nthankas/FORTIS/sim/README.md

# sim/

Simulation work for FORTIS. Currently all sims are in `isaac/` (NVIDIA Isaac Sim 5.1, runs outside the dev container on the Windows host).

## Layout

```
sim/isaac/xdrive/
  canonical/    Active sim scripts (xdrive_realwheel.py, xdrive_reactor_arm_v3.py)
  tools/        Analysis / measurement / standalone utilities
  lib/          Shared modules (sim_config.py, arm_ik_v3.py)
  assets/       USD files (diiid_reactor.usd, omniwheels.usd)
  docs/         Spec docs, summaries, R0 plan
  results/      Per-script output (results/<script_name>/...)
  CHANGELOG.md  Milestone history
```

Rule: every script writes its output into `results/<script_name>/`. No flat dumps in `xdrive/`.

## Canonical scripts

- `xdrive/canonical/xdrive_realwheel.py` -- chassis + real Kaya omni-wheel meshes (1 hub + 10 rollers per wheel as separate rigid bodies, after the 5-sphere roller-collider fix). 44-DOF articulation, CPU physics @ 360 Hz, TGS + CCD. Loads `assets/omniwheels.usd`. Supports `--reactor` for the DIII-D environment. Octagonal-prism skeleton `13.082" x 8.54" x 6.0"` with `3"` chamfered face diagonals at the four 45-degree corners (where the wheels mount), total footprint `19.022" x 14.5"`, `2.0"` belly default.
- `xdrive/canonical/xdrive_reactor_arm_v3.py` -- **active build target.** 4-DOF parallel-link arm on the realwheel chassis, flat-stowed. Single-config: 30" carbon-fiber arm, always loaded with 3 lb payload. Heterogeneous motors (NEMA 17 + Cricket J1/J3, NEMA 23 + EG23 + adapter J2, Hitec D845WP J4), 1.128"x1.128" CF tubes, OAK-D Pro camera at L4 midpoint.

Any new sim that needs the FORTIS chassis copies its build path from `canonical/xdrive_realwheel.py`.

## Tools

- `tools/arm_mc_sweep_v4.py` -- **canonical arm sim.** Headless 5k Monte Carlo sweep of (J1, J2, J3, J4); chassis 10.144 kg + arm 6.515 kg + wheels 4 kg = 20.66 kg total (~45 lb). Records analytical and physics tipping per pose. Supersedes the Cartesian-grid `arm_continuous_sweep_v*` pipeline (J1 was fixed at 0; v4 sweeps all four joints).
- `tools/arm_mc_filter_v4.py` -- analytical post-filter for the MC sweep (chassis/self/floor + reactor envelope + tipping); does NOT drop unstable poses.
- `tools/arm_mc_plot_v4.py` -- sampling histogram, torque table, per-joint torque bar chart (J1-J4), and poloidal cross-section.
- `tools/sweep_orbit_realwheel.py` -- orbit-mode torque sweep on the canonical realwheel chassis. Used to validate the 5-sphere roller collider against the previous single-sphere baseline; results live under `results/orbit_realwheel_5sphere/`.
- `tools/clearance_sweep.py`, `tools/measure_r0_port.py`, `tools/test_drift.py` -- standalone analytical / measurement utilities (no Isaac Sim needed).

## Hardware spec parity

`canonical/xdrive_realwheel.py` and `lib/sim_config.py` match the current spec (~15" x 9" x 6", ODrive M8325s drivetrain).

Mass budget (40 lb total robot, ~18.144 kg):

| Component | Mass | Source |
|---|---|---|
| Chassis body (arm lumped on top) | 14.144 kg | `canonical/xdrive_realwheel.py` `CHASSIS_MASS` |
| Wheels | 4 x 1.0 kg | `canonical/xdrive_realwheel.py` `WHEEL_MASS` |
| Total | 18.144 kg (= 40 lb) | |

Sweep range for parameter studies: `lib/sim_config.py` `MASS_VALUES_KG = [13.6, 18.1, 22.7]` (30 / 40 / 50 lb), default 18.1 kg. `lib/arm_ik_v3.py` carries its own `CHASSIS_MASS = 20.4` constant for analytical tipping calculations.

Refer to the OnShape model and BOM for ground-truth dimensions, not these scripts.

## Reactor environment

- USD: `xdrive/assets/diiid_reactor.usd` (OnShape import, triangle mesh collision applied manually in the GUI - **do not regenerate**)
- Ground-truth mesh (not in git): `E:/Capstone/assets/halfReactor.stl`
- Key radii (in `xdrive/lib/sim_config.py`): inner floor 45.8-54.8", step at 55.5", outer floor 56.2-70.3", step height 4.5", central column r ~ 38"
- Z heights: outer floor -49.3", inner floor -53.8"

## Why x-drive (not skid-steer)

The robot straddles a 4.5" step between the inner and outer reactor floor. Skid-steer point turns while straddling this step were tested in 60 configurations - only 3 completed (5%), all with dangerous tilt and drift.

## Running

Requires Isaac Sim 5.1 on the Windows host (not in the dev container).

```bash
# Canonical chassis on flat ground
IsaacSim/python.bat sim/isaac/xdrive/canonical/xdrive_realwheel.py --gui

# Canonical chassis inside reactor (straddling the step)
IsaacSim/python.bat sim/isaac/xdrive/canonical/xdrive_realwheel.py --gui --reactor

# Chassis + v3 arm (30" CF + 3 lb loaded -- the active build target)
IsaacSim/python.bat sim/isaac/xdrive/canonical/xdrive_reactor_arm_v3.py --gui
IsaacSim/python.bat sim/isaac/xdrive/canonical/xdrive_reactor_arm_v3.py --gui --reactor
IsaacSim/python.bat sim/isaac/xdrive/canonical/xdrive_reactor_arm_v3.py --gui --step

# v4 Monte Carlo arm sweep + post-filter + plots
IsaacSim/python.bat sim/isaac/xdrive/tools/arm_mc_sweep_v4.py
python sim/isaac/xdrive/tools/arm_mc_filter_v4.py
python sim/isaac/xdrive/tools/arm_mc_plot_v4.py

# Analytical clearance sweep (no Isaac Sim needed)
python sim/isaac/xdrive/tools/clearance_sweep.py
```

## Next sim work

Sim 2: R0 port entry. Plan in `xdrive/docs/R0_ENTRY_PLAN.md`. Not started.
