nthankas/FORTIS/sim/isaac/xdrive/results/arm_continuous_sweep/sweep_report.pdf

# Arm Torque Sweep Report

## FORTIS Tokamak Inspection Robot

3 arm lengths (36", 30", 24") x 2 loading (bare / 3 lb payload)
2574 poses per config | Step environment (deployment scenario)
Physics torques validated against analytical gravity to < 0.5%

FORTIS Arm Torque Sweep Report | Page 2/6

## Filtered Results

Torques for physically realizable poses on the step environment. All values in Nm. Peak = worst case for motor sizing. Avg = relevant for power/thermal.

Config | Valid | J2 Peak | J3 Peak | J4 Peak | J2 Avg | J3 Avg | J4 Avg
24" bare | 1845 / 2574 | 8.50 | 3.08 | 0.25 | 3.54 | 1.88 | 0.16
24" loaded | 1845 / 2574 | 16.56 | 7.09 | 0.93 | 6.59 | 4.11 | 0.59
30" bare | 1890 / 2574 | 10.58 | 3.78 | 0.38 | 4.50 | 2.26 | 0.24
30" loaded | 1867 / 2574 | 19.30 | 8.80 | 1.40 | 8.32 | 4.92 | 0.89
36" bare | 1880 / 2574 | 12.53 | 4.77 | 0.50 | 5.22 | 2.84 | 0.32
36" loaded | 1694 / 2574 | 19.42 | 11.09 | 1.87 | 8.47 | 5.89 | 1.19

## Motor Sizing

Design-against peak torques. 36" loaded is the hardest case.

Config | J2 Peak | J3 Peak | J4 Peak
24" bare | 8.5 Nm | 3.1 Nm | 0.3 Nm
24" loaded | 16.6 Nm | 7.1 Nm | 0.9 Nm
30" bare | 10.6 Nm | 3.8 Nm | 0.4 Nm
30" loaded | 19.3 Nm | 8.8 Nm | 1.4 Nm
36" bare | 12.5 Nm | 4.8 Nm | 0.5 Nm
36" loaded | 19.4 Nm | 11.1 Nm | 1.9 Nm

## Arm Configuration

Parameter | Value
Joint mass (J3, J4) | 629 g each
Gripper | 500 g
Camera | 98 g (Orbbec Gemini 2, on L1)
Link tube | 0.79" x 0.79" pultruded CF square
Loaded payload | 3 lb (1360 g) at end effector

Camera on L1 affects J2. Gripper at the tip dominates J3/J4. The 3 lb payload roughly doubles peak torques.

## Link Deflection Under Load

CF tube: 25492 square (1.250" ID, 1.380" OD, 0.065" wall, E = 80.7 GPa, I = 2.42e-8 m4). Linear density 0.226 lb/ft.

### Tip Load on L1 (Loaded Configs)

Outboard of J2: J3 (629 g) + L2 + J4 (629 g) + L3 + EE (1860 g).

Config | L2 Mass | L3 Mass | Total Load
36" loaded | ~110 g | ~30 g | 3.26 kg (32.0 N)
30" loaded | ~88 g | ~22 g | 3.23 kg (31.7 N)
24" loaded | ~73 g | ~15 g | 3.21 kg (31.5 N)

### L1 Deflection

Config | Force (N) | Length (m) | Deflection (mm)
36" loaded | 32.0 | 0.432 | 0.44
30" loaded | 31.7 | 0.381 | 0.30
24" loaded | 31.5 | 0.254 | 0.09

### L2 Deflection

Outboard of J3: J4 (629 g) + L3 + EE (1860 g).

Config | Force (N) | Length (m) | Deflection (mm)
36" loaded | 24.5 | 0.381 | 0.23
30" loaded | 24.4 | 0.305 | 0.12
24" loaded | 24.3 | 0.305 | 0.12

### Total EE Sag (Loaded, Stacked)

Config | L1 | L2 | L3 | Total
36" loaded | 0.44 mm | 0.23 mm | ~0.02 mm | ~0.7 mm
30" loaded | 0.30 mm | 0.12 mm | ~0.01 mm | ~0.4 mm
24" loaded | 0.09 mm | 0.12 mm | ~0.01 mm | ~0.2 mm

Under 1 mm worst case. CF tube stiffness is not a concern.

## Chassis Stability

Static CG projection of chassis (20.4 kg) + arm onto the ground plane, checked against the wheel support polygon. J1 swept 0-345 deg in 15 deg steps.

Assumes level chassis. The 4.5" step tilt will reduce margins on the downhill side. Step tilt correction is a follow-up.

Config | Rejected | Worst Margin | Avg Margin | Tight (< 10 mm)
24" bare | 0 (0.0%) | 43.0 mm / 1.69" | 74.2 mm | 0
24" loaded | 0 (0.0%) | 11.4 mm / 0.45" | 45.7 mm | 0
30" bare | 0 (0.0%) | 33.8 mm / 1.33" | 63.0 mm | 0
30" loaded | 23 (1.2%) | 0.5 mm / 0.02" | 35.5 mm | 139 (7.4%)
36" bare | 0 (0.0%) | 25.2 mm / 0.99" | 54.7 mm | 0
36" loaded | 186 (9.9%) | 0.0 mm / 0.00" | 28.4 mm | 151 (8.9%)

Rejected poses are fully-extended with J1 ~ 90 deg (arm sideways). 24" is unconditionally stable. 36" loaded rejects ~10% at full extension.

## Filtering Details

A pose is rejected if any check fails:
Chassis collision Link sample points inside chassis bounding box (10 mm margin). Self-collision (L3-L1) L3 and L1 segments closer than 15 mm.
Self-collision (L3-J1) L3 enters J1 base volume.
Floor collision Any joint or link midpoint below floor (10 mm margin).
Tipping CG projection outside wheel polygon at any J1 angle.

### Rejection Breakdown

Arm | Loading | Valid | Chassis | Self L3-L1 | Self L3-J1 | Floor | Tip
24" | bare | 1845 (71.7%) | 487 | 100 | 0 | 142 | 0
24" | loaded | 1845 (71.7%) | 487 | 100 | 0 | 142 | 0
30" | bare | 1890 (73.4%) | 380 | 100 | 0 | 204 | 0
30" | loaded | 1867 (72.5%) | 380 | 100 | 0 | 204 | 23
36" | bare | 1880 (73.0%) | 353 | 74 | 4 | 263 | 0
36" | loaded | 1694 (65.8%) | 353 | 74 | 4 | 263 | 186

## Appendix: Raw and Flat Data

### Raw Torques (Unfiltered, Step)

All 2574 poses including impossible configurations.

Config | J2 Peak | J3 Peak | J4 Peak | J2 Avg | J3 Avg | J4 Avg
24" bare | 8.50 | 3.08 | 0.25 | 3.78 | 1.81 | 0.16
24" loaded | 16.56 | 7.09 | 0.93 | 6.86 | 3.95 | 0.59
30" bare | 10.58 | 3.78 | 0.38 | 4.73 | 2.18 | 0.24
30" loaded | 20.65 | 8.80 | 1.40 | 8.53 | 4.75 | 0.89
36" bare | 12.53 | 4.77 | 0.50 | 5.45 | 2.74 | 0.32
36" loaded | 24.60 | 11.09 | 1.88 | 9.89 | 5.96 | 1.18

### Flat Environment (Filtered)

NOT reliable for motor sizing. Chassis slides on flat ground during arm teleport, inflating measured torques by 100-200%. Use step data for all design decisions.

Config | J2 Peak | J3 Peak | J4 Peak | J2 Avg | J3 Avg | J4 Avg
24" bare | 17.37 | 10.55 | 0.75 | 3.67 | 1.93 | 0.16
24" loaded | 22.80 | 11.63 | 1.67 | 6.71 | 4.15 | 0.59
30" bare | 13.17 | 5.86 | 0.71 | 4.52 | 2.27 | 0.24
30" loaded | 33.73 | 16.95 | 2.74 | 8.53 | 5.00 | 0.89
36" bare | 25.39 | 11.74 | 1.19 | 5.74 | 3.05 | 0.34
36" loaded | 37.08 | 24.25 | 4.21 | 10.01 | 6.32 | 1.20

## Method

Isaac Sim headless, 360 Hz. Collision disabled on arm links so every joint combo is reachable. Each pose: teleport to target angles, PD holds ~0.4 s, measure torques ~0.1 s. Post-filter removes impossible poses (chassis/self/floor collision, tipping).
All 6 step configs: 2574/2574 converged, 0 NaN. Physics torques match analytical gravity to < 0.5%.
