nthankas/FORTIS/sim/isaac/xdrive/results/step_arch_optimizer/step_arch_analysis.png

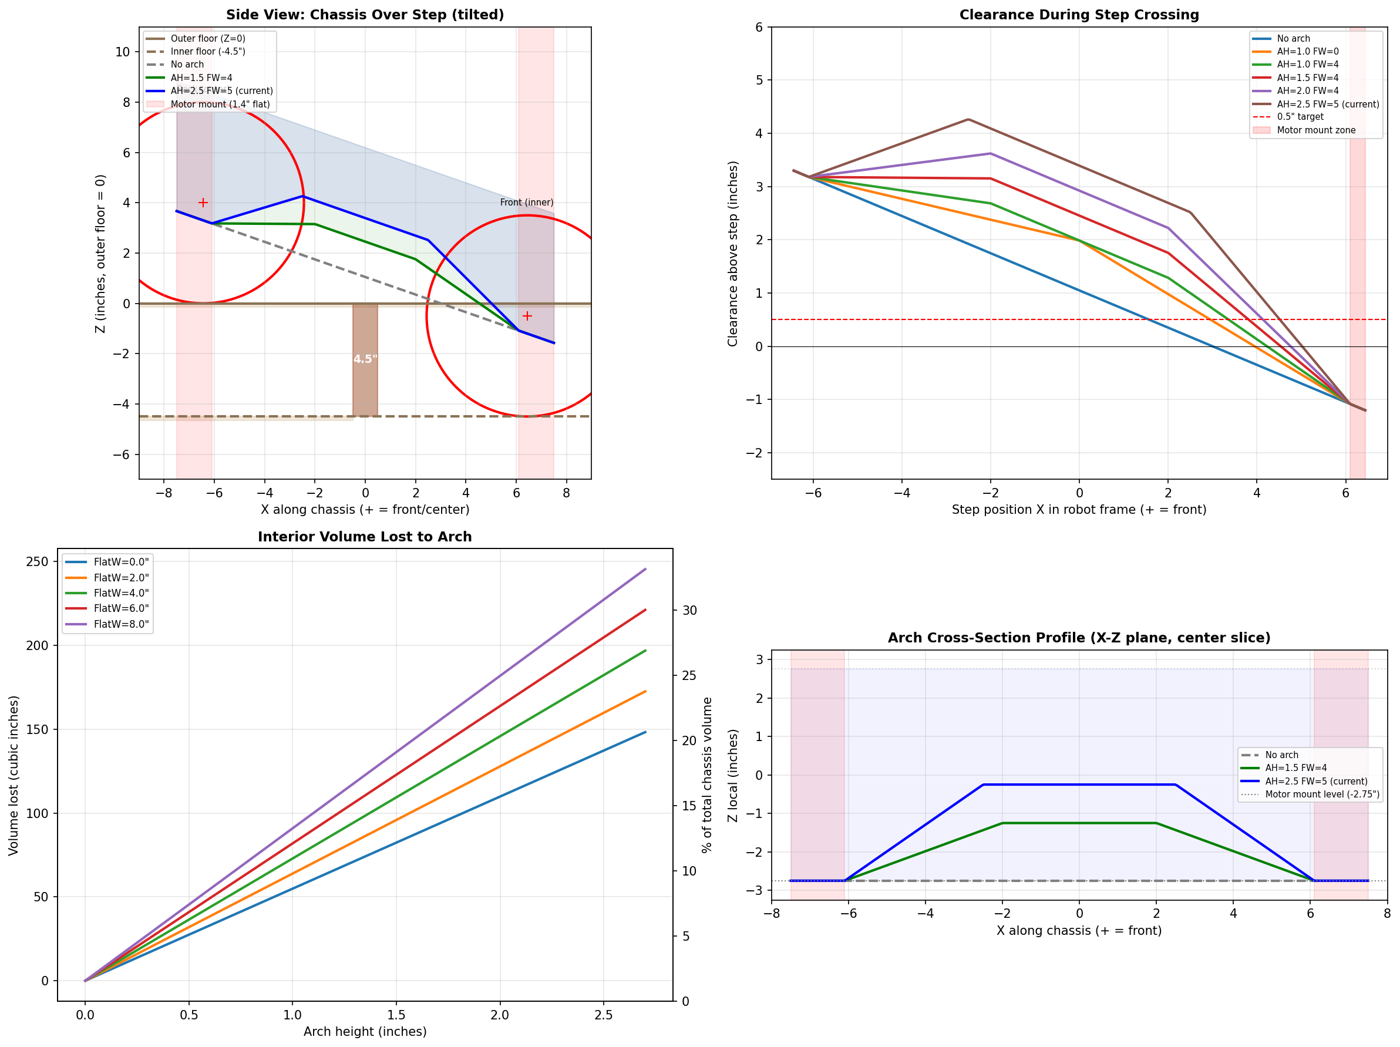
sim/isaac/xdrive/results/step_arch_optimizer/step_arch_analysis.png
