nthankas/FORTIS/sim/isaac/xdrive/results/arm_continuous_sweep/24in_bare_flat_filtered.csv

pose_idx | j2_deg | j3_deg | j4_deg | j2_fk_deg | j3_fk_deg | j4_fk_deg | j1_actual_deg | j2_actual_deg | j3_actual_deg | j4_actual_deg | position_error_deg | tau_j1_Nm | tau_j2_Nm | tau_j3_Nm | tau_j4_Nm | tau_j2_analytical | tau_j3_analytical | tau_j4_analytical | ee_x_m | ee_y_m | ee_z_m | j3_local_x_m | j3_local_z_m | j4_local_x_m | j4_local_z_m | ee_local_x_m | ee_local_z_m | chassis_roll_deg | chassis_pitch_deg | converged | filter_status | filter_chassis | filter_self_L4_L2 | filter_self_L4_J1 | filter_floor | filter_converged | filter_tipping | tip_worst_margin_m | tip_worst_j1_deg | tip_j1_stable_count | tip_cg_x_m | tip_cg_y_m
0 | -30.0 | -170.0 | -150.0 | -30.0 | 10.0 | 30.0 | -0.004 | -29.550 | -169.804 | -149.999 | 0.450 | 0.0992 | -7.6672 | -2.9376 | -0.2459 | -7.6362 | -2.9295 | -0.2466 | 0.384375 | 0.069103 | 0.498678 | 0.263965 | -0.152400 | 0.502646 | -0.239273 | 0.552675 | -0.230452 | -0.217 | -0.042 | True | chassis_collision | True | False | False | False | True | False
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
