nthankas/FORTIS/sim/isaac/xdrive/results/arm_continuous_sweep/24in_bare_flat.csv

pose_idx | j2_deg | j3_deg | j4_deg | j2_fk_deg | j3_fk_deg | j4_fk_deg | j1_actual_deg | j2_actual_deg | j3_actual_deg | j4_actual_deg | position_error_deg | tau_j1_Nm | tau_j2_Nm | tau_j3_Nm | tau_j4_Nm | tau_j2_analytical | tau_j3_analytical | tau_j4_analytical | ee_x_m | ee_y_m | ee_z_m | j3_local_x_m | j3_local_z_m | j4_local_x_m | j4_local_z_m | ee_local_x_m | ee_local_z_m | chassis_roll_deg | chassis_pitch_deg | converged
0 | -30.0 | -170.0 | -150.0 | -30.0 | 10.0 | 30.0 | -0.004 | -29.550 | -169.804 | -149.999 | 0.450 | 0.0992 | -7.6672 | -2.9376 | -0.2459 | -7.6362 | -2.9295 | -0.2466 | 0.384375 | 0.069103 | 0.498678 | 0.263965 | -0.152400 | 0.502646 | -0.239273 | 0.552675 | -0.230452 | -0.217 | -0.042 | True
1 | -30.0 | -170.0 | -120.0 | -30.0 | 10.0 | 60.0 | -0.005 | -29.552 | -169.885 | -119.999 | 0.448 | 0.0395 | -7.6438 | -2.8961 | -0.1888 | -7.5814 | -2.8747 | -0.1918 | 0.377547 | 0.081554 | 0.475519 | 0.263965 | -0.152400 | 0.502646 | -0.239273 | 0.541562 | -0.206620 | -0.150 | -0.032 | True
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
