nthankas/FORTIS/sim/isaac/xdrive/results/arm_continuous_sweep/24in_loaded_flat.csv

pose_idx | j2_deg | j3_deg | j4_deg | j2_fk_deg | j3_fk_deg | j4_fk_deg | j1_actual_deg | j2_actual_deg | j3_actual_deg | j4_actual_deg | position_error_deg | tau_j1_Nm | tau_j2_Nm | tau_j3_Nm | tau_j4_Nm | tau_j2_analytical | tau_j3_analytical | tau_j4_analytical | ee_x_m | ee_y_m | ee_z_m | j3_local_x_m | j3_local_z_m | j4_local_x_m | j4_local_z_m | ee_local_x_m | ee_local_z_m | chassis_roll_deg | chassis_pitch_deg | converged
0 | -30.0 | -170.0 | -150.0 | -30.0 | 10.0 | 30.0 | -0.007 | -29.010 | -169.330 | -149.998 | 0.990 | -5.4290 | -13.9465 | -6.2557 | -0.7999 | -15.0152 | -6.7842 | -0.9145 | 0.365299 | 0.026891 | 0.491494 | 0.263965 | -0.152400 | 0.502646 | -0.239273 | 0.552675 | -0.230452 | -0.009 | -0.007 | True
1 | -30.0 | -170.0 | -120.0 | -30.0 | 10.0 | 60.0 | -0.007 | -28.985 | -169.649 | -119.998 | 1.015 | 0.7987 | -18.2542 | -8.0484 | -0.7870 | -14.8120 | -6.5810 | -0.7114 | 0.354565 | 0.028157 | 0.469578 | 0.263965 | -0.152400 | 0.502646 | -0.239273 | 0.541562 | -0.206620 | -0.021 | -0.024 | True
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
