nthankas/FORTIS/sim/isaac/xdrive/results/arm_continuous_sweep/30in_bare_flat.csv

pose_idx | j2_deg | j3_deg | j4_deg | j2_fk_deg | j3_fk_deg | j4_fk_deg | j1_actual_deg | j2_actual_deg | j3_actual_deg | j4_actual_deg | position_error_deg | tau_j1_Nm | tau_j2_Nm | tau_j3_Nm | tau_j4_Nm | tau_j2_analytical | tau_j3_analytical | tau_j4_analytical | ee_x_m | ee_y_m | ee_z_m | j3_local_x_m | j3_local_z_m | j4_local_x_m | j4_local_z_m | ee_local_x_m | ee_local_z_m | chassis_roll_deg | chassis_pitch_deg | converged
0 | -30.0 | -170.0 | -150.0 | -30.0 | 10.0 | 30.0 | -0.004 | -29.630 | -169.815 | -149.999 | 0.370 | -0.8911 | -10.6520 | -4.1215 | -0.4020 | -9.5115 | -3.6038 | -0.3707 | 0.495104 | 0.096834 | 0.545010 | 0.329956 | -0.190500 | 0.616374 | -0.294748 | 0.691416 | -0.281516 | 0.029 | -0.108 | True
1 | -30.0 | -170.0 | -120.0 | -30.0 | 10.0 | 60.0 | -0.004 | -29.638 | -169.890 | -119.999 | 0.362 | 0.9243 | -9.6909 | -3.6026 | -0.2797 | -9.4292 | -3.5214 | -0.2884 | 0.474418 | 0.098293 | 0.509982 | 0.329956 | -0.190500 | 0.616374 | -0.294748 | 0.674747 | -0.245767 | 0.021 | -0.110 | True
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
