nthankas/FORTIS/sim/isaac/xdrive/results/arm_continuous_sweep/30lb/torque_table_v3_30lb.png

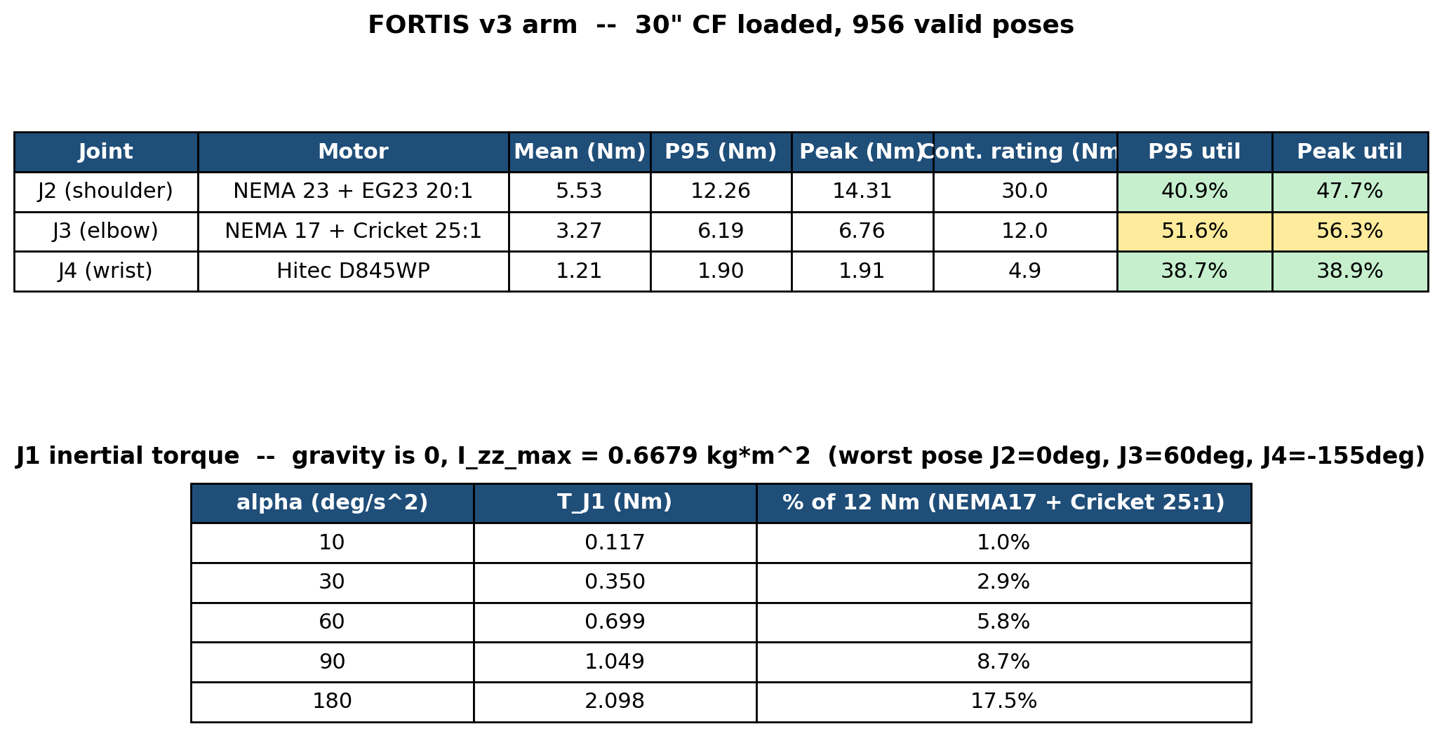
sim/isaac/xdrive/results/arm_continuous_sweep/30lb/torque_table_v3_30lb.png
