nthankas/FORTIS/sim/isaac/xdrive/results/arm_continuous_sweep/stability_v3.png

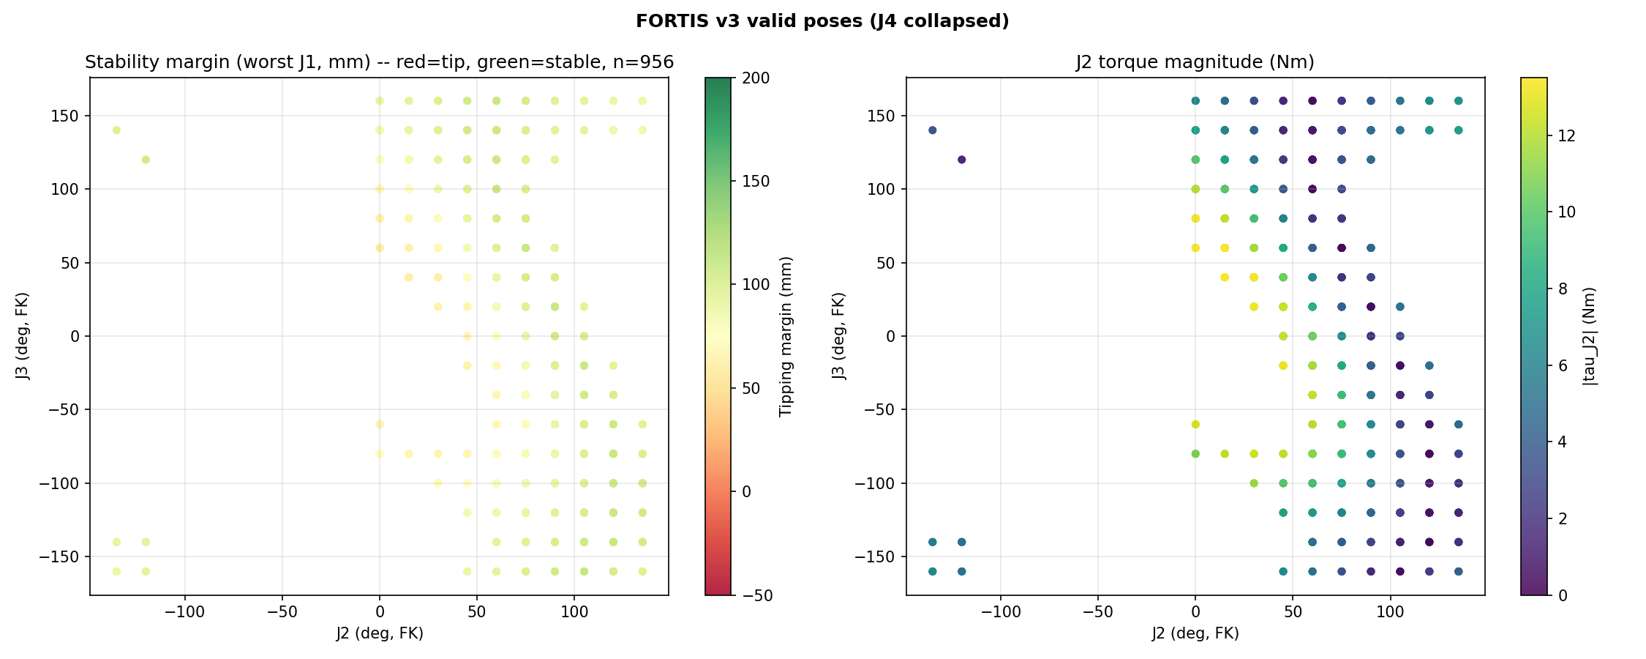
sim/isaac/xdrive/results/arm_continuous_sweep/stability_v3.png
