nthankas/FORTIS/sim/isaac/xdrive/results/arm_mc_sweep/sampling_hist_v4.png

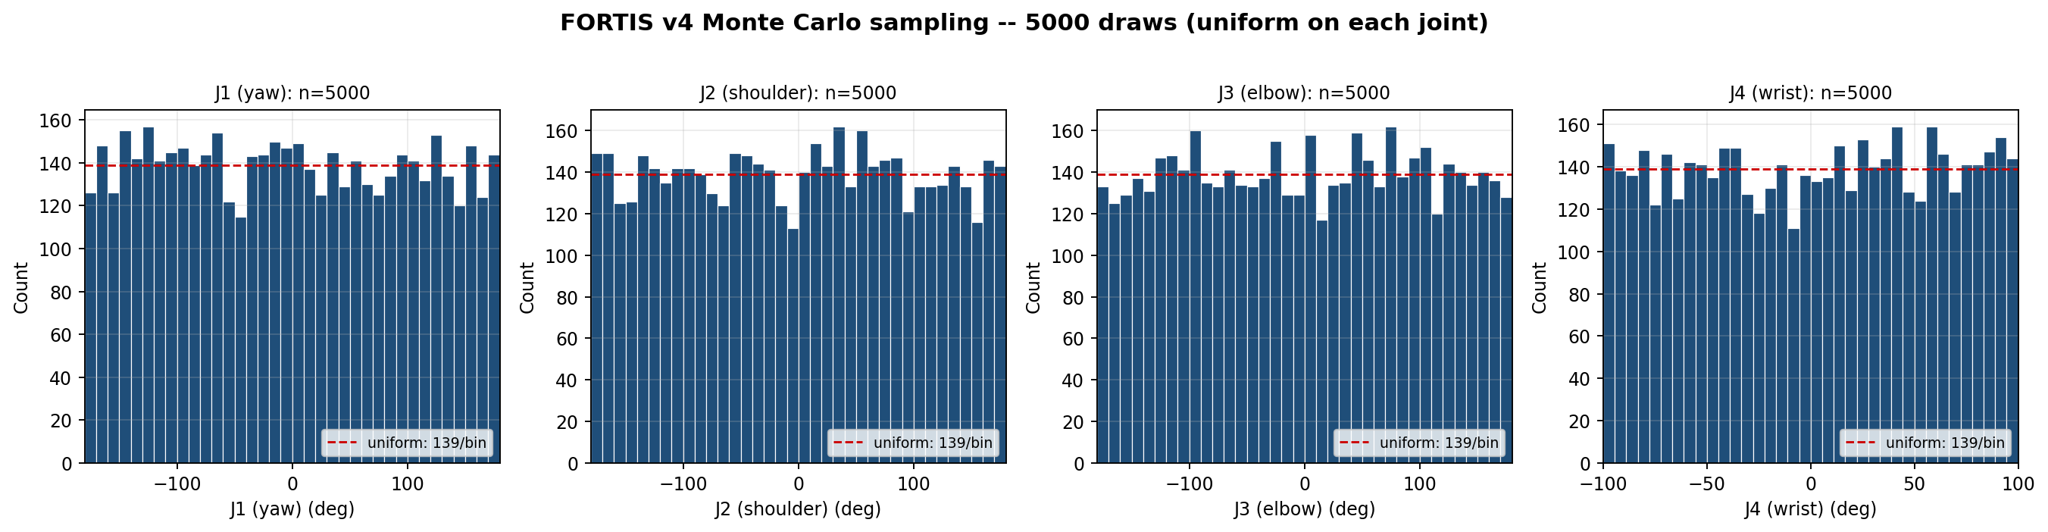
sim/isaac/xdrive/results/arm_mc_sweep/sampling_hist_v4.png
