nthankas/FORTIS/sim/isaac/xdrive/results/arm_mc_sweep/torque_table_v4.png

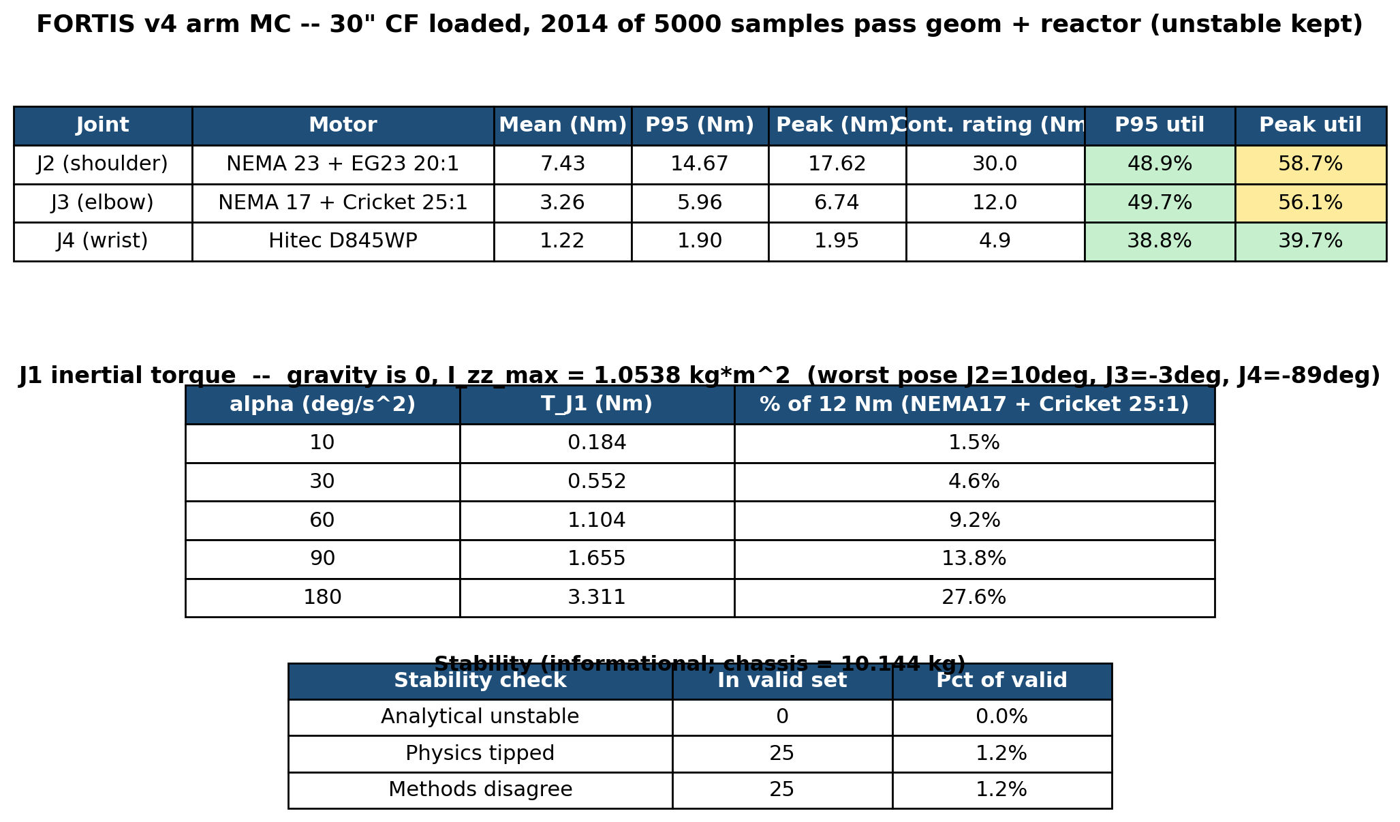
sim/isaac/xdrive/results/arm_mc_sweep/torque_table_v4.png
