nthankas/FORTIS/sim/isaac/xdrive/results/arm_mc_sweep/torques_v4.png

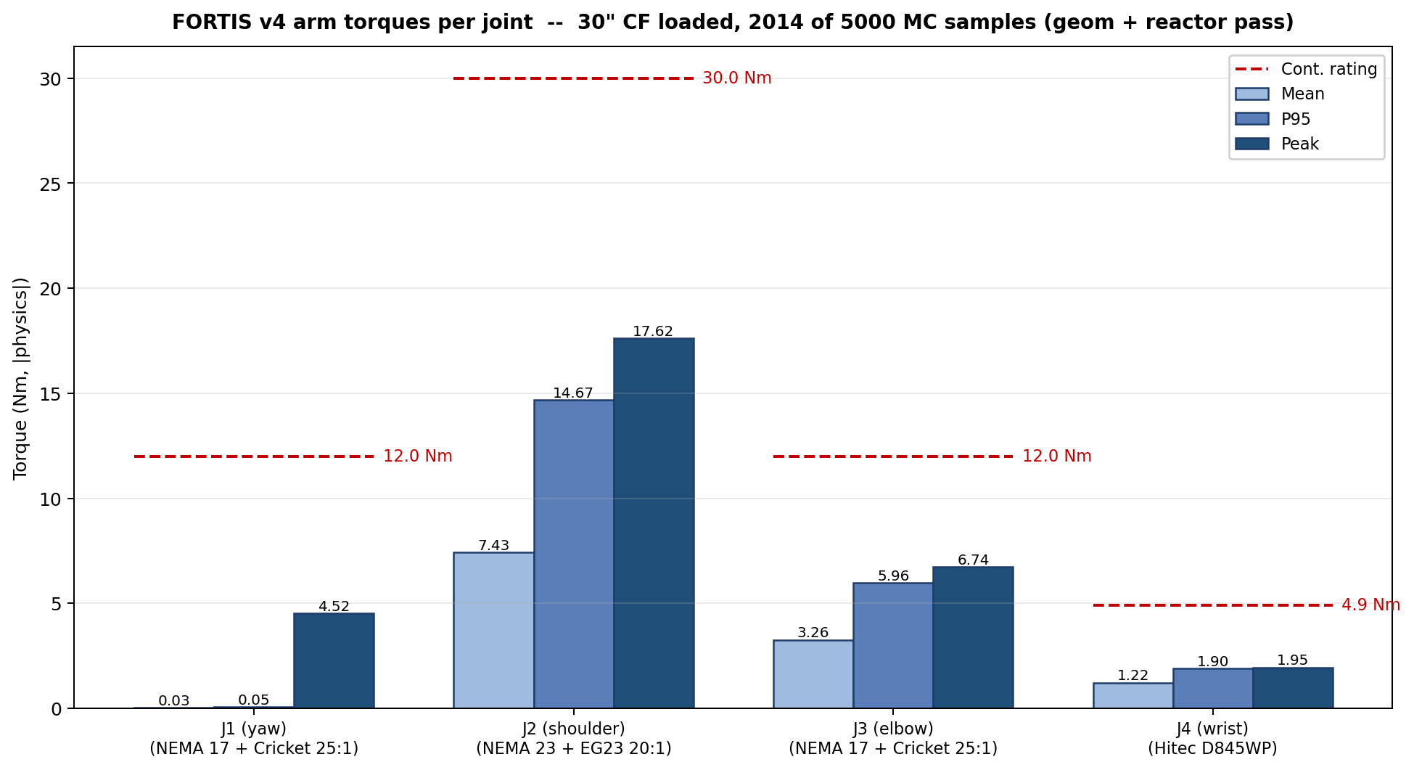
sim/isaac/xdrive/results/arm_mc_sweep/torques_v4.png
