nthankas/FORTIS/sim/isaac/xdrive/results/orbit_realwheel_5sphere/torque_sweep_5sphere_vs_baseline.png

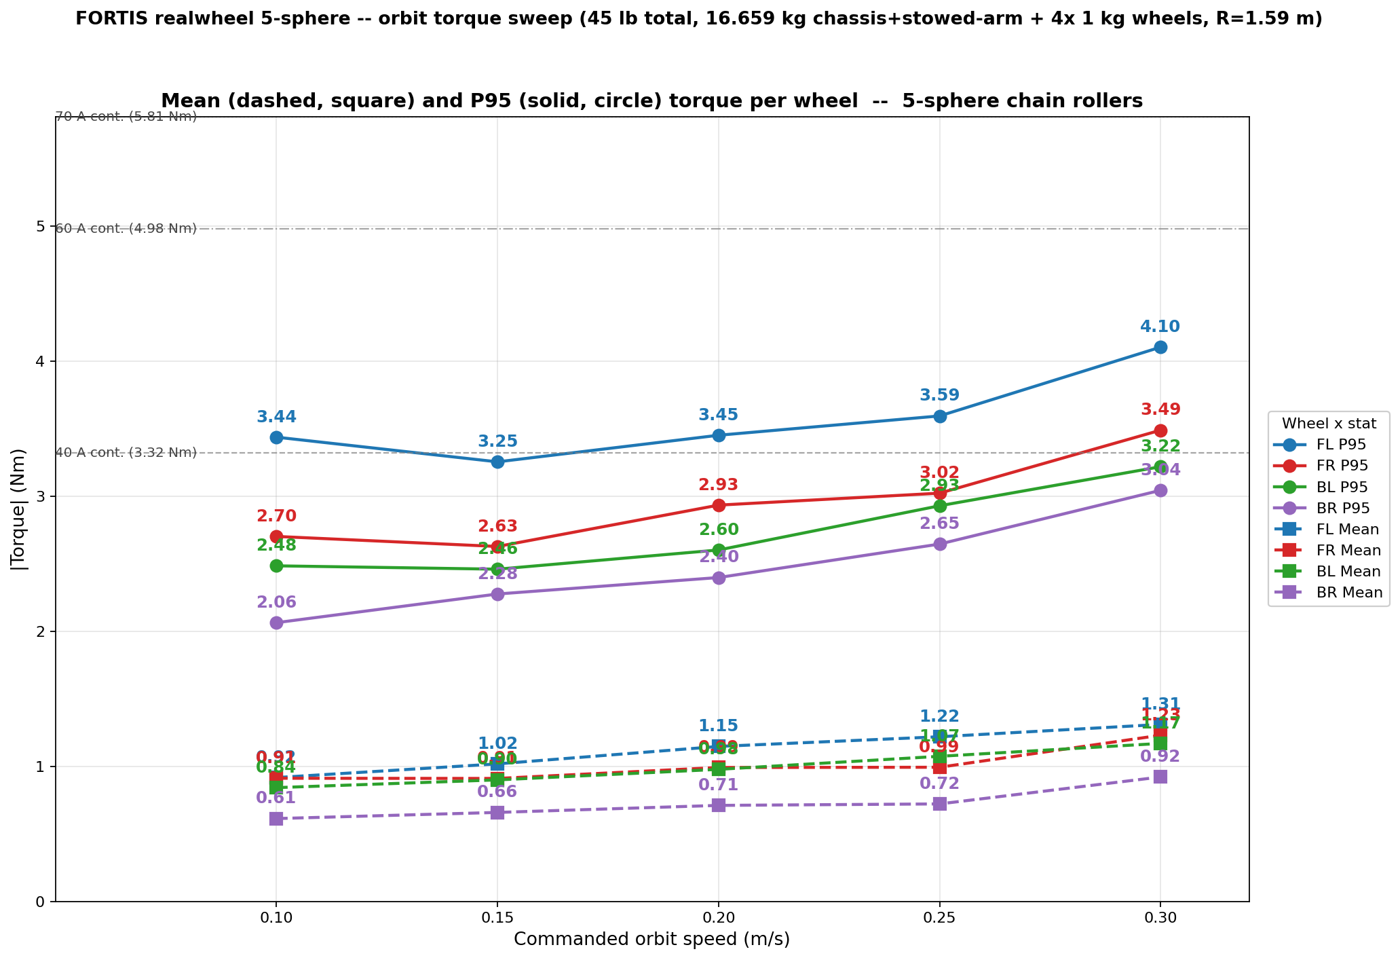
sim/isaac/xdrive/results/orbit_realwheel_5sphere/torque_sweep_5sphere_vs_baseline.png
