nthankas/FORTIS/sim/isaac/xdrive/results/orbit_realwheel_singlesphere/orbit_realwheel_v1_torques.png

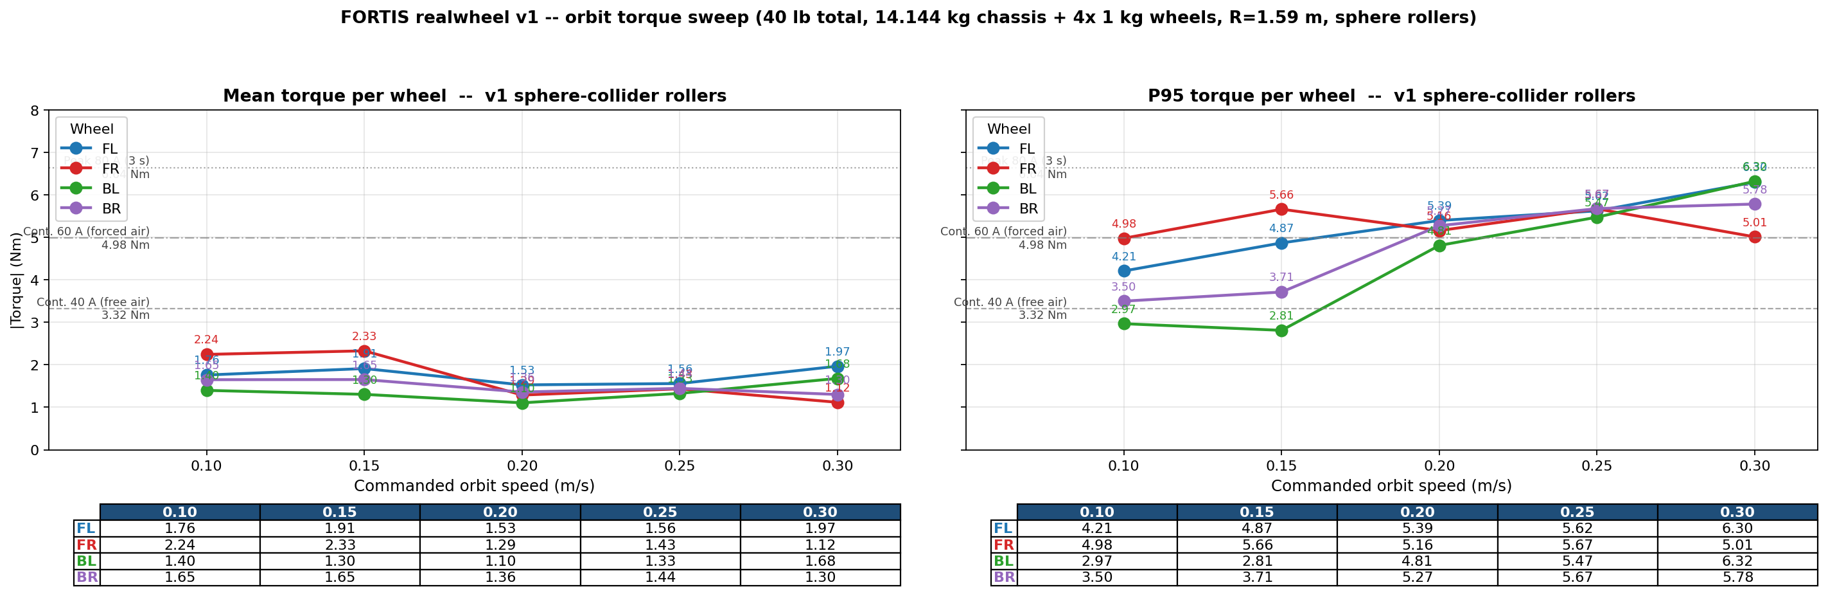
sim/isaac/xdrive/results/orbit_realwheel_singlesphere/orbit_realwheel_v1_torques.png
