nthankas/FORTIS/sim/isaac/xdrive/results/orbit_torque/orbit_torque_summary.png

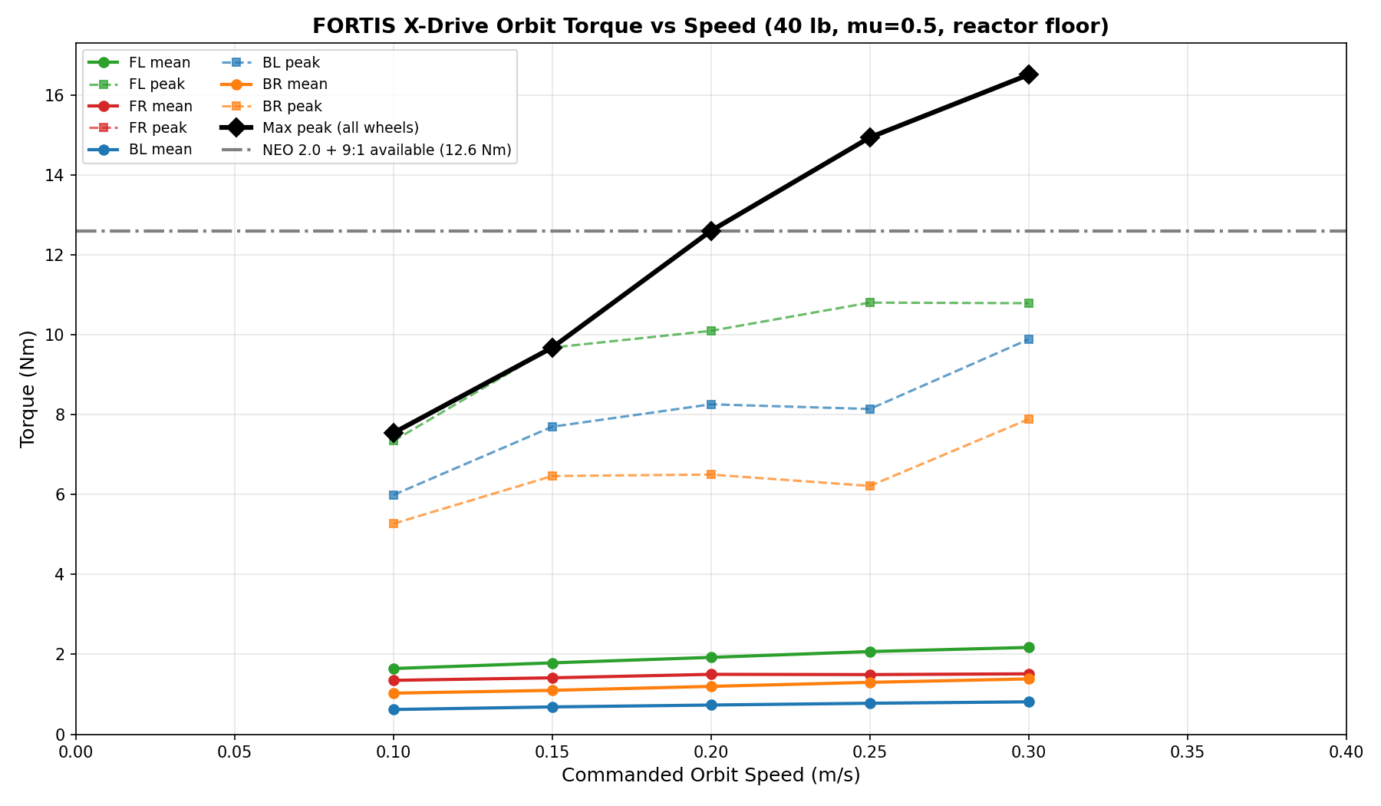
sim/isaac/xdrive/results/orbit_torque/orbit_torque_summary.png
