nthankas/FORTIS/sim/isaac/xdrive/results/orbit_torque/torque_analysis_40lb.png

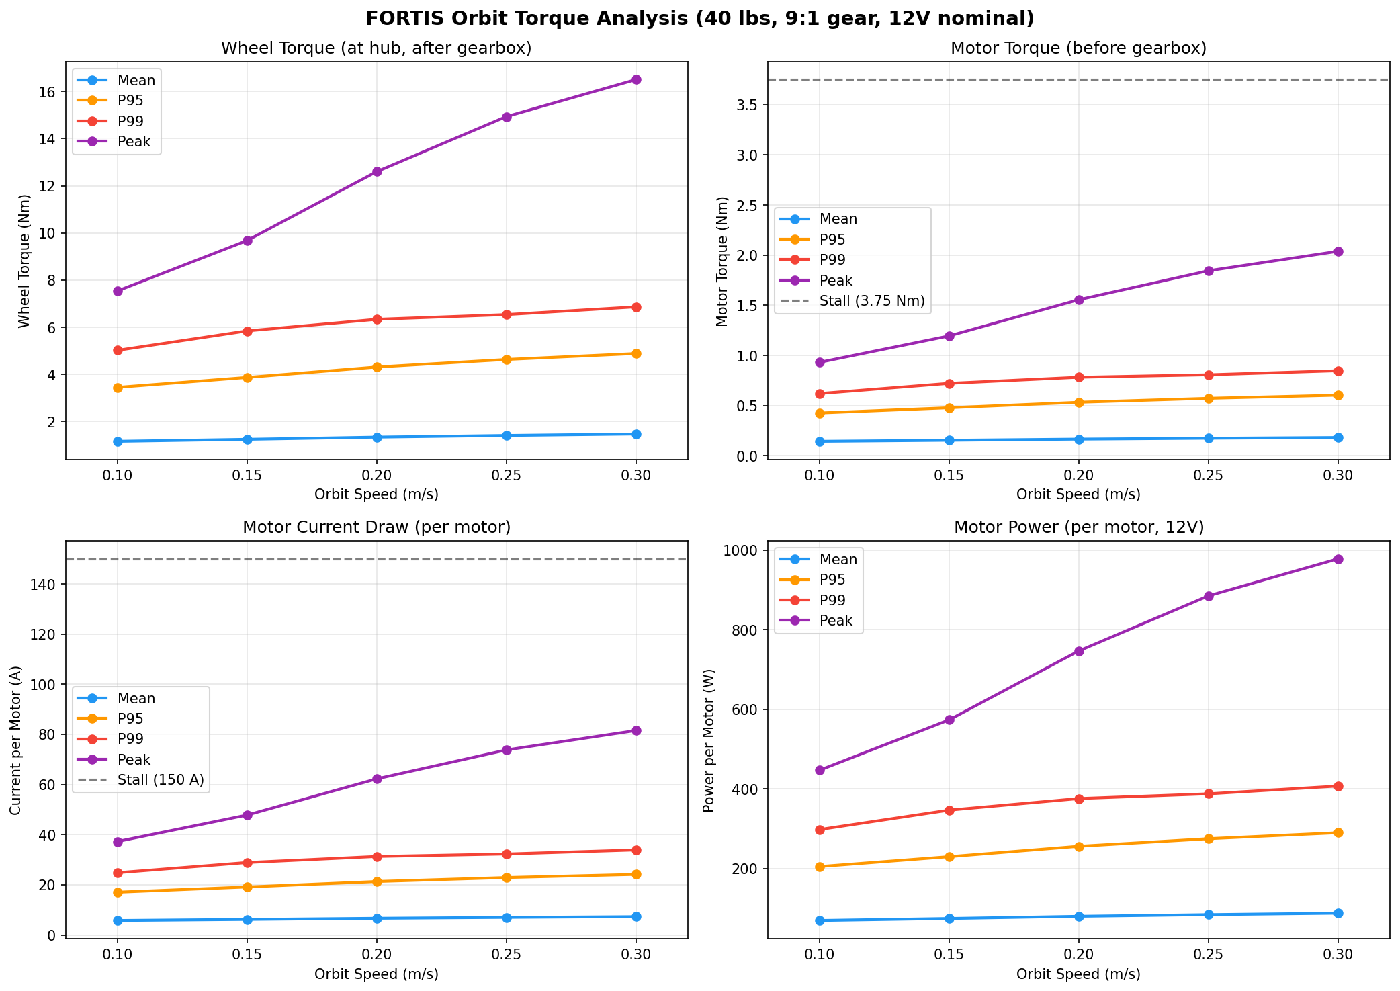
sim/isaac/xdrive/results/orbit_torque/torque_analysis_40lb.png
