nthankas/FORTIS/src/fortis_arm/fortis_arm/arm_controller_node.py

"""
ROS 2 arm controller seam for FORTIS, gated by mission state.

Subscribes
----------
    /fortis/mission_state   std_msgs/String   current mission state name,
                                              latched (TRANSIENT_LOCAL).
                                              Same topic and QoS as
                                              fortis_drive consumes; copy
                                              the pattern, do not invent
                                              a new one.

Publishes
---------
    /fortis/arm/command    sensor_msgs/JointState
        In allowed states the gripper services publish a partial
        JointState naming gripper_left_joint at the calibrated open or
        closed position. The teensy_bridge node translates it to a
        CMD_SET_JOINT_TARGETS frame and drives the servo.

Services
--------
    open_gripper    std_srvs/srv/Trigger
    close_gripper   std_srvs/srv/Trigger
        Both are state-gated against ALLOWED_ARM_STATES (ARM_AT_VIEW,
        INSPECT, PICK, HOLDING, RETURN_HOME). Calls outside
        ALLOWED_ARM_STATES return success=False with an explanatory
        message; calls inside publish the gripper command and return
        success=True with message="gripper command sent".

Why std_srvs/Trigger
--------------------
The gripper is a binary "open" / "close" command from the operator.
Trigger has no payload, just a success/message response, which matches
the contract exactly. A custom service in fortis_msgs would add a build
dependency for no behavioural gain.

Gating rules
------------
Gripper services are honoured only while the mission state is one of
ALLOWED_ARM_STATES. Any other state -- including "no state has been
received yet" -- causes a rejection. Rejection log messages are
throttled per state name so a flood of incoming requests cannot flood
the log.

Threading
---------
SingleThreadedExecutor is sufficient: the state subscription and the
service callbacks all do trivial work (state comparison + log + publish
+ immediate response). MultiThreaded would buy nothing and would invite
a data race on the cached state string.

"""

from __future__ import annotations

import rclpy
from rclpy.duration import Duration
from rclpy.node import Node
from rclpy.time import Time
from sensor_msgs.msg import JointState
from std_msgs.msg import String
from std_srvs.srv import Trigger

from fortis_comms.qos_profiles import latched_qos_profile


# --- Constants ---------------------------------------------------------------

#: Mission states in which arm motion (gripper services) is honoured.
#: Anything else => reject. Frozenset so accidental mutation at runtime
#: raises rather than silently widening the gate.
ALLOWED_ARM_STATES: frozenset[str] = frozenset({
    "ARM_AT_VIEW",
    "INSPECT",
    "PICK",
    "HOLDING",
    "RETURN_HOME",
})

#: Throttle interval for the per-state "rejected request" warning.
REJECT_LOG_THROTTLE_S: float = 1.0

MISSION_STATE_TOPIC: str = "/fortis/mission_state"
ARM_COMMAND_TOPIC: str = "/fortis/arm/command"
OPEN_GRIPPER_SERVICE: str = "open_gripper"
CLOSE_GRIPPER_SERVICE: str = "close_gripper"

#: Actuated gripper joint (URDF); the right jaw mimics it. The teensy
#: bridge maps this prismatic position to a servo pulse width.
GRIPPER_LEFT_JOINT: str = "gripper_left_joint"

#: Throttle-history key used in place of a real state name when logging
#: a rejection that happened before any /fortis/mission_state arrived.
_UNKNOWN_STATE_KEY: str = "<no_state_received>"

#: Message returned on accepted gripper service calls, now that the call
#: publishes a real command to the teensy bridge.
_GRIPPER_SENT_MESSAGE: str = "gripper command sent"


# --- Node --------------------------------------------------------------------


class ArmControllerNode(Node):
    """
    ROS node exposing the gripper services, gated by mission state.

    Holds the most recent mission state (or None until the first message
    arrives) and a per-state throttle map for rejection log messages.
    """

    def __init__(self) -> None:
        super().__init__("arm_controller")

        # Most recent mission state seen. None until first message;
        # guarantees the node rejects requests that race ahead of the
        # state publisher on bring-up.
        self._current_state: str | None = None

        # Per-state timestamp of the last reject warning. Manual throttle
        # because rclpy's throttle is per call site, not per message
        # content; we want one warning per state per second.
        self._last_reject_log: dict[str, Time] = {}

        # Calibrated jaw positions (metres) matching config/arm_calibration
        # gripper_open_us / gripper_closed_us endpoints. Defaults track the
        # URDF gripper_jaw_stroke (0.027 m open, 0.0 closed).
        self._gripper_open_pos = float(
            self.declare_parameter("gripper_open_pos", 0.027).value)
        self._gripper_closed_pos = float(
            self.declare_parameter("gripper_closed_pos", 0.0).value)

        # Latched QoS for the mission_state subscription. Matches the
        # publisher in fortis_safety/mission_state_node and the
        # subscription in fortis_drive/drive_node: TRANSIENT_LOCAL +
        # RELIABLE so a subscriber that connects after the publisher has
        # already announced a state still gets the most recent value on
        # connect, depth=1 because only the latest matters. Diverging
        # from the publisher's profile causes DDS to silently drop the
        # connection -- keep them in sync.
        latched_qos = latched_qos_profile()

        self.create_subscription(
            String,
            MISSION_STATE_TOPIC,
            self._on_mission_state,
            latched_qos,
        )

        self._command_pub = self.create_publisher(
            JointState, ARM_COMMAND_TOPIC, 10
        )

        self.create_service(
            Trigger, OPEN_GRIPPER_SERVICE, self._handle_open_gripper
        )
        self.create_service(
            Trigger, CLOSE_GRIPPER_SERVICE, self._handle_close_gripper
        )

        self.get_logger().info(
            "arm_controller up. Allowed states for arm motion: "
            f"{sorted(ALLOWED_ARM_STATES)}. Awaiting first mission_state."
        )

    # --- Subscription -----------------------------------------------------

    def _on_mission_state(self, msg: String) -> None:
        new_state = msg.data
        if new_state != self._current_state:
            self.get_logger().info(
                f"mission_state: {self._current_state} -> {new_state}"
            )
        self._current_state = new_state

    # --- Gating -----------------------------------------------------------

    def _state_allows_motion(self) -> bool:
        return (
            self._current_state is not None
            and self._current_state in ALLOWED_ARM_STATES
        )

    def _log_rejection(self, kind: str) -> None:
        """Log a rejection, throttled per state name + request kind."""
        state_key = self._current_state or _UNKNOWN_STATE_KEY
        throttle_key = f"{state_key}:{kind}"
        now = self.get_clock().now()
        last = self._last_reject_log.get(throttle_key)
        if last is None or (now - last) > Duration(seconds=REJECT_LOG_THROTTLE_S):
            self._last_reject_log[throttle_key] = now
            self.get_logger().warn(
                f"Rejected {kind} in state {state_key}: "
                f"motion only allowed in {sorted(ALLOWED_ARM_STATES)}"
            )

    # --- Gripper services -------------------------------------------------

    def _handle_open_gripper(
        self, _request: Trigger.Request, response: Trigger.Response
    ) -> Trigger.Response:
        return self._handle_gripper(response, kind="open_gripper")

    def _handle_close_gripper(
        self, _request: Trigger.Request, response: Trigger.Response
    ) -> Trigger.Response:
        return self._handle_gripper(response, kind="close_gripper")

    def _handle_gripper(
        self, response: Trigger.Response, kind: str
    ) -> Trigger.Response:
        if not self._state_allows_motion():
            self._log_rejection(kind)
            response.success = False
            response.message = (
                f"rejected: state {self._current_state or _UNKNOWN_STATE_KEY} "
                f"not in {sorted(ALLOWED_ARM_STATES)}"
            )
            return response
        # Allowed-state path: publish the gripper command to the teensy
        # bridge, which maps the jaw position to a servo pulse width.
        position = (
            self._gripper_open_pos if kind == "open_gripper"
            else self._gripper_closed_pos
        )
        command = JointState()
        command.header.stamp = self.get_clock().now().to_msg()
        command.name = [GRIPPER_LEFT_JOINT]
        command.position = [float(position)]
        self._command_pub.publish(command)
        response.success = True
        response.message = _GRIPPER_SENT_MESSAGE
        return response


def main(args=None):
    rclpy.init(args=args)
    node = ArmControllerNode()
    try:
        rclpy.spin(node)
    finally:
        node.destroy_node()
        if rclpy.ok():
            rclpy.shutdown()


if __name__ == "__main__":
    main()
