nthankas/FORTIS/(commit log)

2026-03-10 Add Isaac Sim simulation scripts, Phase 1/2 results, and skid-steer analysis
    Phase 1: Parametric chassis/arm optimization with Isaac Sim validation
    Phase 2: 60-config step-straddle turn sweep proves skid-steer not viable
    - Only 3/60 configs complete 90-degree turn (5% pass rate)
    - All passing configs show dangerous tilt (85-116 deg) and drift (7-10")
    - Justification for switching to mecanum wheels
    Includes standalone turn calculator, reactor USD scenes, and URDF robot model.
    [fortis_robot.urdf]
2026-03-17 Add Phase 3 X-drive simulation, clean up repo structure
    - X-drive omni wheel simulation with sphere-approximated rollers
    (flat ground, reactor environment, R0 entry maneuver)
    - Drift testing, torque sweep, and analytical clearance calculator
    - Updated README with current project state and drive system specs
    - Added control/ and firmware/ directory placeholders
    - Removed duplicate docs, test renders, and outdated prompt files
    - Updated .gitignore for simulation artifacts
2026-03-17 Clean up repo: remove obsolete phases, rename reactor USD
    - Renamed D-IIIDTokamak_sim.usd to diiid_reactor.usd (working reactor env)
    - Renamed phase2/ to skid_steer_rejection/ with only the scripts that
    proved skid-steer fails (step_sweep.py, build_robot.py, ANALYSIS.md)
    - Removed phase1 analytical scripts, optimizer results, old scene configs,
    inspection utilities, and intermediate files
    - Cleaned .gitignore (no longer blanket-ignores USD files)
    - Updated README to reflect current project structure
    [fortis_robot.urdf]
2026-03-18 Add analysis docs, reactor v2 with belly rollers, fix stale USD path
    Analysis documents:
    - Torque analysis (5:1 vs 9:1 gear ratio comparison)
    - Pivot analysis (X-drive vs skid-steer point turns on step)
    - Orbit analysis (tangential driving on reactor step)
    - X-drive drivetrain analysis (full specs, IK, measured performance)
    - Skid-steer rejection (5% pass rate, 85-116 deg tilt = not viable)
    New simulation scripts:
    - xdrive_reactor_v2.py: arched chassis + belly rollers in reactor
    - xdrive_belly_rollers.py: flat ground test with passive rollers
    - xdrive_r0_rollers.py: R0 entry with belly rollers
    Fix: step_sweep.py pointed to deleted scenes/reactor.usd, now uses
    xdrive/diiid_reactor.usd
2026-03-29 Add real omni wheel simulation, remove superseded scripts
    Add xdrive_realwheel.py: X-drive simulation using Kaya omniwheels.usd
    mesh geometry with per-roller revolute joints (10 rollers/wheel, 44 DOF
    articulation). Chassis is arched octagonal prism with recessed belly for
    step clearance. Supports --reactor and --tunnel spawn modes.
    Add omniwheels.usd: Kaya MX-12W wheel assembly, scaled to 203mm at
    runtime for AndyMark 8" Dualie dimensions.
    Remove torque_sweep.py (crashed, will redo in realwheel),
    xdrive_belly_rollers.py and xdrive_r0_rollers.py (superseded by ball
    transfer approach for R0 entry).
2026-04-02 Add orbit torque profiling and R0 entry contact reporting
    Orbit torque sweep (orbit_torque.py):
    - Subprocess-per-speed architecture for Isaac Sim World singleton
    - Tested at 0.1-0.3 m/s and 1.0-2.0 m/s on reactor floor
    - Logs per-wheel torque at 100Hz, saves CSV + summary plot
    - Gearbox analysis: 9:1 single stage sufficient at 0.2 m/s (2.6x P95 margin)
    - 25:1 (5:1+5:1) recommended for higher speeds up to 1.5 m/s
    R0 entry contact reporting (xdrive_realwheel.py --contact):
    - PhysxContactReportAPI on chassis to detect reactor scraping
    - Logs contact position, normal, force, chassis orientation
    - Saves JSON report + 4-panel matplotlib visualization
    [orbit_torque_0.10mps.csv, orbit_torque_0.15mps.csv, orbit_torque_0.20mps.csv, orbit_torque_0.25mps.csv, orbit_torque_0.30mps.csv, orbit_torque_1.00mps.csv, orbit_torque_1.25mps.csv, orbit_torque_1.50mps.csv]
2026-04-05 Reorganize xdrive/ into canonical/deprecated/tools/lib/assets/docs/results
    Flat 19-file xdrive/ folder led to accidental use of deprecated chassis
    models. Split into tier-labeled subdirectories so the path itself signals
    canonical vs deprecated status.
    Structure:
    canonical/ xdrive_realwheel.py, xdrive_reactor_arm.py
    deprecated/ xdrive_o3dyn, xdrive_reactor, xdrive_reactor_v2, xdrive_r0_entry_v2
    tools/ test_drift, clearance_sweep, step_arch_optimizer, orbit_torque, measure_r0_port
    lib/ sim_config.py
    assets/ diiid_reactor.usd, omniwheels.usd
    docs/ arm_spec.md, R0_ENTRY_PLAN.md, XDRIVE_SIM_SUMMARY.md
    results/ results/<script_name>/ enforced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
2026-04-07 4-DOF arm redesign: 36/30/24" configs, headless pose sweep, self-collision
    Shrink arm from 5-DOF/50" to 4-DOF/36" (17+15+4"), add 30" and 24" configs
    with CLI flags (--36arm, --30arm, --24arm, --armloaded). Enable articulation
    self-collision so arm collides with chassis (PhysX auto-filters adjacent
    joint pairs). Add depth camera on J2 shoulder, 500g gripper at L4 tip.
    New tools:
    - arm_pose_sweep.py: headless sweep of ~7600 poses per config, measures
    torques, tipping, EE contact, chassis drift. Inter-pose reset prevents
    collision cascade. Early bailout on arm-chassis collision.
    - parse_sweep_results.py: aggregates all sweep CSVs into comparison tables
    and charts.
    Deprecate old 5-DOF a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
2026-04-08 Collision-free arm torque sweep: all 12 configs, analytical post-filter
    Replace broken collision-ON continuous sweep (0.06% success) with
    collision-free teleport sweep + analytical post-filter. 100% convergence,
    0 NaN across all 12 configs (3 arms x 2 loading x 2 env).
    - arm_continuous_sweep.py: headless Isaac Sim sweep, collision disabled
    - arm_sweep_filter.py: post-filter (chassis/self/floor/tipping checks)
    - lib/arm_ik.py: shared FK, analytical torques, collision geometry
    Results in results/arm_continuous_sweep/ with raw + filtered CSVs,
    summary JSONs, and sweep_report.md with motor sizing tables.
    Deprecated old scripts moved to deprecated/scripts/, old results to
    deprecated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
    [24in_bare_flat.csv, 24in_bare_flat_filtered.csv, 24in_bare_reactor.csv, 24in_bare_step.csv, 24in_bare_step_filtered.csv, 24in_loaded_flat.csv, 24in_loaded_flat_filtered.csv, 24in_loaded_reactor.csv]
2026-04-08 Rewrite sweep report for readability, add PDF and deflection data
    Restructured sweep_report.md for non-technical readers: results up
    front, filtering details at the bottom, plain language throughout.
    Added link deflection tables (CF tube bend analysis), moved flat
    environment data to a supplementary section with unreliability warning.
    Added generate_pdf.py and sweep_report.pdf for clean distribution.
2026-04-10 Motor controller base complete
2026-04-10 ODriveS1 CAN code
2026-04-10 ik fk solver for xdrive done, comms library sorted and old IK arm deprecated in comms/deprecated
2026-05-01 chore: reorganize repo layout
    - Rename control/comms/ -> control/fortis_comms/
    - Rename simulation/ -> sim/
    - Move deprecated Coppelia IK reference to legacy/coppelia_ik_reference/
    - Update .gitignore paths for sim/ and add .pytest_cache/
    [24in_bare_flat.csv, 24in_bare_flat_filtered.csv, 24in_bare_reactor.csv, 24in_bare_step.csv, 24in_bare_step_filtered.csv, 24in_loaded_flat.csv, 24in_loaded_flat_filtered.csv, 24in_loaded_reactor.csv]
2026-05-01 docs: rewrite README, replace STATE.md with sim-scoped doc
    Old README listed REV NEO motors, ESP32 firmware, and outdated chassis
    dimensions. New README reflects current hardware: ODrive M8325s + S1,
    Jetson Orin Nano Super, ~15"x9"x6" / ~40 lb chassis, X-drive omni.
    STATE.md was 90% sim-scoped content with stale hardware. Move sim layout
    and rules to sim/README.md, drop the rest. Hardware truth lives in the
    OnShape model and BOM, not in this repo.
    Also register event_console as a console_script entry point so
    'ros2 run fortis_safety event_console' works as documented.
2026-05-01 docs(fortis_safety): expand docstrings and why-comments
    - mission_state_machine: document the table-driven pattern, guard
    mechanism, and how to add new states/events/context fields.
    - mission_state_node: explain why the state topic uses TRANSIENT_LOCAL
    + RELIABLE QoS, and why callbacks call try_step rather than step.
    - event_console: explain the daemon-spin / main-thread REPL split,
    the latched context QoS, and the parse_bool rationale.
    - Fix stale path in test_mission_state_machine docstring.
    No logic changes.
2026-05-01 docs: add CONTRIBUTING.md, and per-tree READMEs
    - : project, hardware, dev workflow, blocking chain,
    communication style, do-not-touch list, procurement constraints.
    - CONTRIBUTING.md: where each kind of code lives, build/test commands,
    conventions, hard rules.
    - control/README.md and legacy/README.md describe the intent of those
    trees (what belongs there, what doesn't).
    - control/fortis_comms/README.md documents the integration path into a
    future fortis_drive package and lists known bugs to fix before
    ROS-wrapping.
2026-05-01 chore: remove empty firmware/ directory
    Original ESP32-firmware split is obsolete. The Jetson Orin Nano Super
    runs all robot software inside the dev container at /workspace, so
    there's no separate MCU codebase to host. Drop the placeholder dir and
    the references to it in README, , and CONTRIBUTING.md.
2026-05-02 sim: port v2 arm + stability sweep from arm-v2-torque-report
    Brings in the V2 arm system and step-stability sweep work that was sitting on
    arm-v2-torque-report (last touched 2026-04-11) into the new sim/ layout.
    V2 arm (heterogeneous motors, 1.25x1.38 CF, L4 camera):
    - canonical/xdrive_reactor_arm_v2.py
    - lib/arm_ik_v2.py
    - tools/arm_continuous_sweep_v2.py
    - tools/arm_sweep_filter_v2.py
    - results/arm_continuous_sweep/30in_loaded_step_v2{,_filter_summary,_filtered,_summary}.{csv,json}
    - results/arm_continuous_sweep/sweep_report_v2.md
    Step stability sweep (tilt-corrected tipping):
    - tools/arm_stability_sweep.py
    - lib/arm_ik.py: tipping_at_j1_tilted()
    - results/arm_stability_sweep/{36in_loade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
    [30in_loaded_step_v2.csv, 30in_loaded_step_v2_filtered.csv]
2026-05-02 sim: apply chassis-pivot WIP from arm-v2-torque-report stash
    Applies stash@{0} content (made 2026-05-01 on arm-v2-torque-report) to the
    sim/ tree. Key change is the chassis skeleton pivot:
    - 13.082" x 8.54" x 6.0" skeleton (was 15.354" x 9.353" x 7.1")
    - 19.022" x 14.5" footprint with wheels flush at corners
    - No chamfer (rectangular skeleton)
    - BELLY_HEIGHT default 2.0" (was 2.5")
    Touches both v1 and v2 arm canonical scripts, both arm_ik libs, sim_config
    constants, and all sweep tools (continuous v1/v2, stability, filter v1/v2).
    The stash also deleted root-level inverse_kinetmatic_solver.py, which is a
    no-op here since main already moved it to legacy/coppelia_ik_reference/.
    The stash's S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
2026-05-02 sim: add orbit_torque_v2.py (rectangular skeleton chassis)
    Untracked file from the working tree (~921 lines), authored 2026-05-01
    alongside the chassis pivot. Same orbit test as orbit_torque.py but built
    on the v2 13.082" x 8.54" x 6.0" rectangular skeleton with wheels flush
    at the corners.
    Listed as 'NEW' in the stash STATE.md update; pairing it with the chassis
    pivot stash so the two land together.
2026-05-02 sim: register v2 arm + new chassis spec in sim/README.md
    - Add xdrive_reactor_arm_v2.py to canonical scripts
    - Add arm_ik_v2.py to the lib listing
    - Add a Tools section listing v1/v2 sweep + filter tools and
    arm_stability_sweep
    - Replace the "stale spec values" warning: skeleton is now 13.082" x 8.54"
    x 6.0" (rectangular, no chamfer, 2.0" belly), matching current hardware
    spec; only the 20.4 kg mass constant is still stale
    - Add the v2 arm command to the Running section
2026-05-02 sim: log 2026-05-01 v2 arm + chassis pivot in CHANGELOG
    Adds the 2026-05-01 milestone covering the 143e7db merge:
    - chassis skeleton pivot to 13.082" x 8.54" x 6.0" rectangular (no chamfer),
    19.022" x 14.5" wheel-flush footprint, 2.0" belly default
    - v2 arm system (canonical + lib + sweep tools + initial 30in_loaded_step
    results)
    - step stability sweep + tipping_at_j1_tilted in arm_ik
    - --metal/--cf flag in v1 arm
    - orbit_torque_v2.py
    - consolidated 7 stale branches into main (preserved as archive/* tags
    on origin)
2026-05-02 sim: revert flush-wheel collision change, keep new chassis dims
    The chassis-pivot WIP (907467a) shrank wheel_offset from 40mm to 5mm and
    swapped chassis collision from convexDecomposition of the visual mesh to
    a 1"-inset box. With flush wheels the inner-side roller spheres on each
    wheel now sit inside the chassis box collider, so PhysX violently pushes
    them out — manifests as erratic chassis sliding/skidding on flat ground
    and rollers that don't roll cleanly.
    Restoring the working pre-pivot collision (convexDecomposition) and the
    40mm wheel offset clears the issue. New chassis dimensions
    (13.082 x 8.54 x 6.0", 3" chamfers, 1.272" motor mounts, 2.059" arch
    flat, 2" belly) are unchanged. Wh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
2026-05-02 fortis_msgs: scaffold ament_cmake msg package with 4 message types
    Adds custom messages used across the FORTIS stack:
    ChassisCamClick - operator click on a chassis camera image
    GraspCandidate - planner-emitted grasp pose with confidence + approach
    MissionState - richer mission-state announcement (state + previous + stamp)
    WheelVelocities - per-wheel angular velocity command for the X-drive
    ament_cmake (not ament_python) because rosidl message generation requires
    the C++ build pipeline. Depends on builtin_interfaces, geometry_msgs,
    std_msgs.
2026-05-02 fortis_drive: implement state-gated drive_node
    Subscribes to /cmd_vel (geometry_msgs/Twist) and /fortis/mission_state
    (std_msgs/String, latched TRANSIENT_LOCAL+RELIABLE QoS matching
    mission_state_node). Publishes per-wheel angular velocities on
    /fortis/drive/wheel_velocities when the state is ORBIT or RETURN_HOME,
    and explicit zeros on /fortis/drive/zero_velocities otherwise so a
    downstream stop is never inferred from absence of a message.
    Wraps the existing fortis_comms.xdrive_kinematics IK solver -- no
    duplication of the H matrix or the wheel-speed saturation logic. Since
    fortis_comms is not yet a packaged Python project, drive_node walks up
    from __file__ to find <repo>/control and prepen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
2026-05-02 fortis_drive: add drive_node tests covering gating, IK, and bring-up race
    Five rclpy-backed tests stand up a real DriveNode plus a helper node
    and exercise the topic round trip through DDS:
    - ORBIT accepts /cmd_vel and the IK output matches xdrive_ik_solver
    - IDLE rejects /cmd_vel and publishes zeros on the explicit-stop topic
    - RETURN_HOME accepts /cmd_vel (also a permitted state)
    - State transitions IDLE -> ORBIT -> IDLE flip the gate each time
    - /cmd_vel before any /fortis/mission_state is rejected
    Mocking rclpy and calling _on_cmd_vel directly would test the formula
    but not the QoS contract; we go through the wire to catch QoS-mismatch
    regressions in either direction.
    [test_drive_node.py]
2026-05-03 fortis_drive: scope lint scaffolds to package, fix docstring style
    The test_flake8 and test_pep257 scaffolds linted the entire workspace
    (sim/, build/, install/, control/, ...) when pytest was run from the
    repo root, drowning the real signal under ~1500 errors from generated
    and non-PEP-8 code. Resolve the lint target from __file__ so the scope
    follows the scaffold no matter where pytest was launched.
    Also fix the small set of D205/D213/D400/D415/D401 docstring nits in
    drive_node.py and test_drive_node.py that the previously-broken scope
    masked.
    [test_drive_node.py]
2026-05-03 fortis_comms: add ament_python package (move from control/fortis_comms)
    Promote fortis_comms from a pre-ROS Python module under control/ to a
    first-class ament_python package under src/, so consumers (fortis_drive
    today, fortis_arm next) can declare it as a regular <depend> instead of
    importing through a sys.path shim.
    Modules preserved in shape:
    - motor_base.Motor / MotorStatus
    - odrive_s1.ODrive_S1 (relative-import fix only: from .motor_base ...)
    - xdrive_kinematics.{xdrive_ik_solver, xdrive_fk_solver, WHEEL_RADIUS, H, ...}
    ekf.py rewritten:
    - Constructor now takes optional config: str | Path | Mapping | None.
    None loads bundled fortis_comms/cfgs/ekf_params.json via
    importlib.resourc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
    [ekf.py, motor_base.py, odrive_s1.py, xdrive_kinematics.py]
2026-05-03 fortis_drive: depend on fortis_comms package, drop sys.path shim
    fortis_comms is now a real ament_python package under src/fortis_comms,
    so colcon puts it on PYTHONPATH automatically after install/setup.bash
    is sourced. The walk-up-and-prepend shim in drive_node.py is no longer
    necessary.
    Changes:
    - package.xml: add <depend>fortis_comms</depend>.
    - drive_node.py: remove _ensure_fortis_comms_importable() and the
    Importing fortis_comms section of the module docstring; switch to
    direct from fortis_comms.xdrive_kinematics import ...; drop now-unused
    sys / Path imports and the noqa: E402 markers.
    - test/test_drive_node.py: remove the comment that explained why
    fortis_drive had to be impo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
    [test_drive_node.py]
2026-05-03 control: delete legacy fortis_comms tree, update top-level README
    All modules previously under control/fortis_comms have been promoted to
    src/fortis_comms in the prior commits, and fortis_drive no longer
    imports through the sys.path shim. Nothing else in control/ depends on
    fortis_comms (verified via grep), so the entire control/ directory goes.
    README.md updates:
    - Repo layout: drop control/, list fortis_comms under src/.
    - fortis_comms test snippet: switch from "cd control/fortis_comms ; pytest"
    to "colcon test --packages-select fortis_comms".
    - Status table: fortis_comms row no longer mentions sys.path shim.
    - Doc pointer: control/fortis_comms/README.md -> src/fortis_comms/README.md.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
    [ekf.py, motor_base.py, odrive_s1.py, xdrive_kinematics.py]
2026-05-03 fortis_msgs: add MoveToPose action for the arm controller seam
    Define the MoveToPose action used by fortis_arm/arm_controller's
    move_to_pose action server. There is no off-the-shelf ROS 2 action
    with a geometry_msgs/PoseStamped goal, so a custom one is the only
    path to fulfilling the contract Task 2 demands.
    action/MoveToPose.action:
    - Goal: geometry_msgs/PoseStamped target_pose
    - Result: bool succeeded, string message
    - Feedback: float32 progress (0.0 to 1.0)
    CMakeLists.txt: add action_files set, pass to rosidl_generate_interfaces
    alongside msg_files. No new package dependencies (PoseStamped is in
    geometry_msgs which is already declared).
    README.md: document the new action under a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
2026-05-03 fortis_arm: scaffold ament_python package skeleton
    Standard ament_python layout matching fortis_drive: package.xml,
    setup.py, setup.cfg, resource marker, empty fortis_arm/__init__.py.
    package.xml depends: rclpy, fortis_msgs, fortis_comms, std_msgs,
    std_srvs, geometry_msgs, sensor_msgs. std_srvs is added because the
    gripper services use std_srvs/srv/Trigger; sensor_msgs is declared
    ahead of joint-state publication in the next pass.
    setup.py registers a single console_script:
    arm_controller = fortis_arm.arm_controller_node:main
2026-05-03 fortis_arm: add state-gated arm_controller node (action server + gripper services)
    ROS 2 node named "arm_controller" exposing the arm contract used by
    targeting, the operator UI, and (eventually) the grasp planner. No
    kinematics here -- the contract is the deliverable, the motion is
    deferred to a follow-up that wires up the Teensy serial protocol, the
    IK, and trajectory generation.
    Endpoints:
    - Subscription /fortis/mission_state, std_msgs/String, latched
    (TRANSIENT_LOCAL + RELIABLE, depth=1). Same topic and QoS profile
    as fortis_drive consumes; copied verbatim so reading one node tells
    you how the other works.
    - Action server move_to_pose, fortis_msgs/MoveToPose. Goal callback
    rejec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
2026-05-03 fortis_arm: add gating + bring-up tests, lint scaffolds
    test_state_gating.py: parametrized over the full mission_state_machine
    state set (IDLE, ORBIT, TARGETING, ARM_AT_VIEW, INSPECT, PICK, HOLDING,
    RETURN_HOME, FAULT). Asserts that:
    - move_to_pose action is accepted in every state in ALLOWED_ARM_STATES
    and the result is the documented stub (succeeded=False, message
    containing "kinematics not implemented");
    - move_to_pose is rejected at the gate in every other state;
    - open_gripper / close_gripper return success=False with the gripper
    stub message in allowed states, and success=False with a "rejected"
    message in disallowed states;
    - a transition IDLE -> ARM_AT_VIEW -> IDLE flips the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
2026-05-03 fortis_arm: add README with hardware reference and contract notes
    src/fortis_arm/README.md:
    - What ships in the scaffold (move_to_pose action, gripper services,
    mission_state subscription) and what is intentionally deferred (IK,
    trajectories, Teensy serial, position-file recovery).
    - Allowed mission states for arm motion.
    - Why std_srvs/Trigger over a custom service for the gripper.
    - Hardware reference for the kinematics pass to start from:
    * Motion controller: Teensy 4.1 on Jetson Port 4.
    * TeensyStep -> SN74HCT245N level shifter -> CL57T-V41 drivers for
    J1, J2, J3.
    * Hitec D845WP servo on J4 (PWM, no level shift needed).
    * ServoCity 3219-0001-0002 rotational servo gripper.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
2026-05-03 fortis_drive: harden test_drive_node against parallel-test DDS races
    Discovered while running the workspace-wide colcon test required by
    the fortis_arm scaffold task. Pre-existing flake exposed when colcon
    runs fortis_drive and fortis_arm test processes concurrently: the
    fixed-duration spins after publish_state and publish_twist are not
    long enough to cover DDS discovery on a loaded box, and the assertions
    on wheel_msgs / zero_msgs see empty lists.
    The tests passed reliably when fortis_drive was the only package
    running tests; they failed half the time once fortis_arm was added.
    Fix: replace fixed-duration spins with state-and-output polling.
    - publish_state polls the node's cached _curren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
    [test_drive_node.py]
2026-05-03 fortis_integration_tests: scaffold cross-package integration test package
    New ament_python package, test-only (no runtime entry points), hosting
    launch_testing-based integration tests that bring up multiple real
    nodes and exercise the contract between them.
    First test: test/test_safety_drive_integration.py.
    Brings up the real fortis_safety/mission_state_node and
    fortis_drive/drive_node in the same launch. Four cases:
    1. test_01_default_idle_rejects_cmd_vel_for_one_second
    IDLE is published latched on startup; sustained /cmd_vel for 1.2 s
    must produce explicit zero_velocities, never wheel_velocities.
    2. test_02_orbit_accepts_cmd_vel_and_publishes_correct_ik
    START_ORBIT moves FSM int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
2026-05-04 test(fortis_arm,fortis_drive): function-scope rclpy for DDS isolation between parametrized tests
    Module-scoped rclpy.init shared one DDS participant across the whole parametrized run. A destroyed helper publisher's TRANSIENT_LOCAL latched sample could then race into the next test's spin and overwrite the cached gate value, producing the "rejected: state IDLE not in [...]" flake on the first parametrized cases after a state-changing block of tests.
    Function-scoped fixture gives each test a fresh DDS participant. Apply the same change preventively to fortis_drive before its parametrized surface grows with the upcoming ODrive ROS 2 driver wrap. Also order helper.destroy_node before node.destro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
    [test_drive_node.py]
2026-05-04 chore: add .gitattributes to normalize line endings to LF
    "* text=auto eol=lf" forces LF in both index and working tree on every checkout. Without this, Windows tools (VS Code, Git for Windows with core.autocrlf=true) silently re-terminate lines as CRLF on save, producing large "dirty" working trees of pure line-ending churn that pollute diffs and create spurious merge conflicts.
    git add --renormalize . renormalized three previously-CRLF files (.devcontainer/devcontainer.json, docker/Dockerfile.dev, docker/docker-compose.yml). Diffs are symmetric per-file (insertions == deletions) -- pure line-ending change, no content modified.
2026-05-04 sim: deprecate v1/v2 arm + chassis variants, sort deprecated/ into arm/chassis subdirs
    Move all v1 arm-sweep CSV results, v1 arm tooling, v1/v2 chassis scripts
    (xdrive_reactor_arm{,_v1,_v2}, xdrive_reactor{,_v2}, xdrive_o3dyn,
    xdrive_r0_entry_v2), and superseded torque/optimizer scripts
    (orbit_torque{,_v2}, step_arch_optimizer) into deprecated/. Sort
    deprecated/scripts/ into arm/ and chassis/ subdirs and refresh
    deprecated/README.md.
    [24in_bare_flat.csv, 24in_bare_flat_filtered.csv, 24in_bare_step.csv, 24in_bare_step_filtered.csv, 24in_loaded_flat.csv, 24in_loaded_flat_filtered.csv, 24in_loaded_step.csv, 24in_loaded_step_filtered.csv]
2026-05-04 sim: realwheel 5-sphere roller collider + orbit-test mode for torque sweep
    Replace single-sphere roller collider with a 5-sphere chain along the
    roller tangent; gives a near-continuous contact arc while staying within
    the GPU PhysX 64-vert convex hull limit. Bump CHASSIS_MASS to 14.144 kg
    (40 lb total robot incl. arm + 4x1 kg wheels).
    Add headless --orbit-speed/--orbit-orbits/--orbit-radius/--orbit-csv mode
    that records per-wheel torques and chassis pose to CSV for the orbit-on-
    step torque sweep. tools/sweep_orbit_realwheel.py drives the sweep over
    0.10-0.30 m/s and aggregates path-length, tracking, and torque stats.
    Results captured for both colliders: results/orbit_realwheel_singlespher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
    [orbit_realwheel_0.10mps.csv, orbit_realwheel_0.15mps.csv, orbit_realwheel_0.20mps.csv, orbit_realwheel_0.25mps.csv, orbit_realwheel_0.30mps.csv]
2026-05-04 sim: arm v3 continuous sweep + per-weight (30/35/40 lb) torque result splits
    Add v3 arm sim (xdrive_reactor_arm_v3) with arm_ik_v3, plus
    arm_continuous_sweep_v3 / arm_sweep_filter_v3 / arm_sweep_plot_v3
    tooling. Capture 30in_loaded_step_v3 source sweep + per-weight
    filtered CSVs, torque tables, torque histograms, torques plot, and
    poloidal cross-sections at 30 / 35 / 40 lb total robot mass. v2 arm
    sweep results moved into v2/ subdir.
    Update sim/README.md and xdrive/docs/XDRIVE_SIM_SUMMARY.md to point at
    v3 as the canonical arm sim.
    [30in_loaded_step_v2.csv, 30in_loaded_step_v2_filtered.csv, 30in_loaded_step_v3.csv, 30in_loaded_step_v3_filtered.csv, 30in_loaded_step_v3_filtered_30lb.csv, 30in_loaded_step_v3_filtered_35lb.csv, 30in_loaded_step_v3_filtered_40lb.csv]
2026-05-04 docs: refresh READMEs and changelog for current state of main
    Top-level README: drop the duplicate "fortis_arm blocked on URDF" status row (the row above already says it's a working scaffold), update the per-package status table for fortis_comms / fortis_arm / fortis_integration_tests, refresh the package-list footer, and replace the old per-package test snippets with a single full-workspace colcon-test recipe (113 tests, 0 failures) plus a launch_test pointer for the cross-package integration test.
    sim/README.md: promote canonical/xdrive_reactor_arm_v3.py to the active build target (was v2), list the v3 sweep tools (arm_continuous_sweep_v3, arm_sweep_filter_v3, arm_sweep_plot_v3) and sweep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
2026-05-04 docs: correct mass budget in sim and analysis READMEs
    sim/README.md "Hardware spec parity" section was claiming the sim's chassis mass was "still 20.4 kg" -- in fact canonical/xdrive_realwheel.py uses CHASSIS_MASS = 14.144 kg (chassis body, arm lumped on top) + 4 x 1.0 kg wheels = 18.144 kg total, which matches the 40 lb robot target. Replace the stale single-number claim with a breakdown table.
    analysis/xdrive_analysis.md fix the legacy "45 lbs (20.4 kg)" entry. The 45 lb / 20.4 kg figure was the design target before the mass budget was tightened; the current target is 40 lb / 18.144 kg.
    Note: lib/arm_ik_v3.py and lib/arm_ik_v2.py still carry CHASSIS_MASS = 20.4 -- that constant is intent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
2026-05-04 docs: correct chassis geometry and motor identity in analysis + sim READMEs
    I'd written "rectangular skeleton" in two places I authored and let an old REV NEO + MAXPlanetary specification sit in the analysis hardware-parameters table. The canonical chassis is and has been an octagonal prism: 13.082" x 8.54" x 6.0" body with 3" chamfered face diagonals at the four 45-degree corners where the wheels mount. The drive motors are ODrive M8325s brushless x4 driven by ODrive S1 controllers over CAN -- not REV NEO + MAXPlanetary.
    Three corrections: sim/README.md canonical-script blurb (rectangular -> octagonal w/ chamfers), sim/isaac/xdrive/deprecated/README.md orbit_torque_v2.py row, and analysis/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
2026-05-04 docs: chassis is and has always been octagonal w/ 3in chamfers; drivetrain is direct
    Two corrections: the 2026-05-01 changelog entry incorrectly described the new skeleton as "rectangular" -- the change was a tightening of the octagonal-prism dimensions, not a shape pivot. Editing in place because the entry as written misrepresents what shipped (the realwheel chassis was octagonal before and after the resize). Also restoring the direct-drive row in the analysis hardware table now that it's confirmed: M8325s mounts directly to the wheel hub, no gearbox in the drivetrain.
2026-05-05 sim: arm v4 Monte Carlo sweep + orbit torque chart restyle
    - New v4 arm pipeline: 5k uniform MC over (J1,J2,J3,J4) with analytical +
    physics tipping; replaces v3 3,888-pose grid with J1=0.
    Mass budget: 10.144 kg chassis + 6.515 kg arm + 4x 1 kg wheels = 20.66 kg.
    - v4 plots: sampling histogram, J1-J4 torque bar chart, torque table,
    poloidal cross-section (denominator now matches valid_rows).
    - Deprecate v3 arm scripts (arm_continuous_sweep_v3, arm_sweep_filter_v3,
    arm_sweep_plot_v3) under deprecated/scripts/arm/.
    - Restyle 5-sphere orbit torque chart to match single-sphere v1: 2 panels
    (Mean | P95), line+marker, only 40 A and 60 A continuous-rating lines.
    - Add ORBIT_SIM_FIX_CONTEX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
    [30in_loaded_step_v4_mc20.csv, 30in_loaded_step_v4_mc5000.csv, 30in_loaded_step_v4_mc5000_filtered.csv]
2026-05-05 sim: deprecate arm continuous sweep v2, MC v4 pipeline is canonical
    - Move tools/arm_continuous_sweep_v2.py and arm_sweep_filter_v2.py into
    deprecated/scripts/arm/. The Cartesian-grid continuous sweep (v1/v2/v3)
    is fully retired in favour of the v4 Monte Carlo pipeline
    (arm_mc_sweep_v4 / _filter_v4 / _plot_v4).
    - sim/README.md: list xdrive_reactor_arm_v3.py as the canonical arm
    script (was stale on v2), drop v2 sweep entries from tools list, add
    v2 row to deprecated, update the run example to v3.
    - Delete ORBIT_SIM_FIX_CONTEXT.md (one-shot scratchpad, served its
    purpose).
2026-05-05 sim: move arm_continuous_sweep results into deprecated/results/
    The continuous-sweep tools (v1/v2/v3) were moved into deprecated/scripts/
    in earlier commits, but the v3 result tree was still living under the
    active results/ root next to the v4 MC outputs. Move it to
    deprecated/results/arm_continuous_sweep_v3/ so the active results/
    directory only contains current pipeline outputs (arm_mc_sweep,
    orbit_realwheel_*).
    The v2 sub-tree under that dir comes along inside arm_continuous_sweep_v3/
    since v2 and v3 results were combined under one folder; preserving the
    nested layout rather than splitting them.
    [30in_loaded_step_v2.csv, 30in_loaded_step_v2_filtered.csv, 30in_loaded_step_v3.csv, 30in_loaded_step_v3_filtered.csv, 30in_loaded_step_v3_filtered_30lb.csv, 30in_loaded_step_v3_filtered_35lb.csv, 30in_loaded_step_v3_filtered_40lb.csv]
2026-05-05 sim: move skid_steer_design under sim/isaac/deprecated/
    The skid-steer rejection analysis was archived in spirit (the directory
    was always 'do not use'), but lived as a sibling of xdrive/ at the
    sim/isaac/ root. Move it under sim/isaac/deprecated/ so the active
    sim/isaac/ directory only contains the live xdrive/ tree.
    Updated references:
    - sim/README.md layout block + the back-reference under 'Why x-drive'
    - analysis/skid_steer_rejection.md data-files table (also fixes stale
    'simulation/' prefix from before the 2026-05-01 simulation/ -> sim/
    rename).
    Historical entries in sim/isaac/xdrive/CHANGELOG.md are left as-is --
    they describe events at the time, not current state.
2026-05-05 sim: orbit sweep open-loop, 5s settle, chassis+arm mass override
    Three-knob fix per user spec for the 5-sphere P95 problem:
    - Drop the closed-loop position tracker in xdrive_realwheel.py orbit-test
    branch. Now: one xdrive_ik(0, -speed, +speed/r0) call after settle,
    joint targets set once, no per-frame correction. The chassis is allowed
    to drift radially -- this is a torque measurement, not a path-follow.
    - Bump in-sim settle from 2.0s to 5.0s (--orbit-settle CLI flag, default
    5.0). Lets rollers and contact forces stabilize before any wheel cmd.
    - Add --chassis-mass CLI override on xdrive_realwheel.py (additive,
    default = current CHASSIS_MASS=14.144 unchanged). sweep_orbit_realwheel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
    [orbit_realwheel_0.10mps.csv, orbit_realwheel_0.15mps.csv, orbit_realwheel_0.20mps.csv, orbit_realwheel_0.25mps.csv, orbit_realwheel_0.30mps.csv]
2026-05-05 sim: 5-sphere orbit results, open-loop fix produces clean P95
    Numbers (P95 worst wheel, all under 60A continuous rating 4.98 Nm):
    - 0.10 m/s: 3.44 Nm (was ~9 Nm with closed-loop tracker)
    - 0.15 m/s: 3.25 Nm
    - 0.20 m/s: 3.45 Nm
    - 0.25 m/s: 3.59 Nm
    - 0.30 m/s: 4.10 Nm
    Peak bounded ~7-11 Nm across the sweep (was ~31 Nm at 0.10 m/s).
    Mean torques 0.6-1.3 Nm across all wheels and speeds. The 5-sphere
    collider is now slightly LOWER P95 than the single-sphere baseline at
    the same speeds, consistent with more contact patches distributing load.
    Tracking % is 18-24% by design -- open-loop lets the chassis drift
    radially. R_mean settles ~1.42m vs commanded 1.59m. Not a fault; this
    is a torque-charac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
    [orbit_realwheel_0.10mps.csv, orbit_realwheel_0.15mps.csv, orbit_realwheel_0.20mps.csv, orbit_realwheel_0.25mps.csv, orbit_realwheel_0.30mps.csv]
2026-05-05 sim: cap orbit chart y-axis at 70 A continuous (5.81 Nm) for slide fit
    - Add 70 A reference line (5.81 Nm) to THRESH list, dotted style.
    - Drop ax.set_ylim upper from 8 to 5.81 so the chart compresses
    vertically. Highest P95 in the sweep is 4.10 Nm (FL @ 0.30 m/s),
    comfortably under the cap.
    - Regenerate torque_sweep_5sphere_vs_baseline.png.
2026-05-05 sim: combine mean and P95 into single panel on orbit chart
    - Single ax instead of side-by-side mean | P95 panels.
    - Per wheel: solid line + circle marker for P95, dashed line + square
    marker for Mean. Same color per wheel so eye groups by wheel.
    - Legend moved outside plot (right side) so 40/60/70 A continuous-rating
    threshold labels on the left don't collide with it.
    - Title states the linestyle/marker convention explicitly so the chart
    reads on its own without legend study.
    - Y-axis still capped at 5.81 Nm (70 A continuous).
2026-05-05 sim: deprecate single-sphere orbit baseline + add RESULTS.md tables
    - Move sim/isaac/xdrive/results/orbit_realwheel_singlesphere/ to
    deprecated/results/. The 5-sphere chain is now the canonical roller
    model; the single-sphere data was a historical comparator.
    - Add RESULTS.md to results/arm_mc_sweep/ summarizing the v4 MC arm
    sweep (final arm sim): 5,000 poses, 2,014 valid, 1,989 stable,
    per-joint mean/P95/peak vs hardware continuous ratings.
    - Add RESULTS.md to results/orbit_realwheel_5sphere/ summarizing the
    open-loop orbit sweep at 5 speeds with the chassis+stowed-arm mass
    budget. Per-wheel mean/P95/peak table + headline 'worst wheel per
    speed' table + ODrive M8325s 40/60/70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
    [orbit_realwheel_0.10mps.csv, orbit_realwheel_0.15mps.csv, orbit_realwheel_0.20mps.csv, orbit_realwheel_0.25mps.csv, orbit_realwheel_0.30mps.csv]
2026-05-06 docs(readme): trim top-level README to current canonical state
    Down from 159 to ~70 lines. Drop the verbose mission_state_node usage example + topics table (lives in src/fortis_safety/README.md, which I'm adding in a follow-up commit), collapse three test-pass subsections into one, drop the redundant package-list footer after the status table, remove the hardcoded "113 tests" expectation in favor of "expect 0 failures" (counts rot), and trim the per-row status descriptions to one phrase each.
    Updates while editing: precise chassis dim (13.082 x 8.54 x 6 octagonal w/ 3in chamfers), direct drive note, v3 arm config (30in CF + 3 lb loaded, NEMA 17/23 motor stack), OAK-D Pro on L4 midpoint per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
2026-05-06 docs(fortis_comms): mark odrive_s1, motor_base, ekf as interim scaffolding
    Module-level docstrings only -- no behavior change. Each file now states (1) it's interim, (2) what upstream package replaces it (ODrive's official ROS 2 driver for the motor pair, robot_localization for ekf), (3) do not extend, and (4) points at docs/adr/0002 (added in a follow-up commit) for the broader decision record.
    odrive_s1.py also documents the three known bugs that were going to be on the previous cleanup-plan's Tier 1 -- decision now is to leave them in place because the file is being replaced, but documenting them so a reader who DOES try to use it knows what to expect.
    [ekf.py, motor_base.py, odrive_s1.py]
2026-05-06 docs(readme): align top-level README with v4 sim canonical state
    Three small reconciliations after the user's v4 Monte Carlo sweep landed on main: bump total robot mass from 40 lb to ~45 lb (the v4 sweep's mass budget is chassis 10.144 kg + arm 6.515 kg + wheels 4 kg = 20.66 kg ~= 45 lb, vs the older 40 lb "chassis + arm lumped" accounting); drop the "(build target: v3)" parenthetical since the v3 designation is sim-script-version, not hardware-version, and was a confusing overload; expand the "Isaac Sim" status row to spell out chassis script + v3 arm script + v4 sweep tooling, since the sim/README.md already covers the detail and this row is a one-liner status not a roadmap.
2026-05-06 chore(legacy): retire motor_base/odrive_s1/ekf and MoveToPose action server
    Move four pieces out of the active build into legacy/. All four are
    replaced by ros2_control + standard ROS 2 packages.
    Moves (git mv preserves history for the first three):
    - src/fortis_comms/fortis_comms/motor_base.py
    -> legacy/deprecated_motor_stack/motor_base.py
    - src/fortis_comms/fortis_comms/odrive_s1.py
    -> legacy/deprecated_motor_stack/odrive_s1.py
    - src/fortis_comms/fortis_comms/ekf.py
    -> legacy/deprecated_ekf/ekf.py
    - MoveToPose action server extracted out of
    src/fortis_arm/fortis_arm/arm_controller_node.py into
    legacy/deprecated_arm_action/move_to_pose_action_server.py
    (the rest of arm_controll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
    [arm_controller_node.py, ekf.py, motor_base.py, odrive_s1.py]
2026-05-06 feat(firmware): add Teensy 4.1 protocol spec, firmware skeleton, and mock
    - firmware/teensy/PROTOCOL.md: complete binary protocol spec covering
    framing (start/len/seq/type/payload/CRC-16-CCITT/end), all message
    types (CMD_*/RSP_*/EVT_*), uint16 fault bitmask, error codes,
    EEPROM ping-pong checkpointing scheme, and watchdog timing.
    - firmware/teensy/main.ino: skeleton implementation using TeensyStep
    for J1/J2/J3 and the Servo library for J4 + gripper, with
    MOCK_MODE compile-time flag, EEPROM recovery + checkpoint, frame
    parser, fault scan, and heartbeat watchdog. TODOs flag homing,
    MCU temperature read, and pure-velocity mode for the next pass.
    - tools/mock_teensy.py: pty-backed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
    [main.ino]
2026-05-06 docs(firmware): add Teensy handoff guide for Cesar
    Documents the current state of firmware/teensy/, what's safe to change vs.
    what needs cross-team coordination (the protocol contract), the TeensyStep
    2.3.4 vs. Teensy core 1.60.0 incompatibility blocking arduino-cli compile,
    the mock watchdog-at-startup quirk, the open TODOs in main.ino, and a
    recommended bring-up order from compile through hardware integration.
2026-05-06 fix(arm): rename Note section to satisfy pep257 (D413/D416)
    The cleanup commit added a Note section to the module docstring;
    pep257 treats Note as a recognized section name and requires the
    colon form plus a trailing blank line. Rename to Migration note
    (matches the multi-word style of the other sections) so pep257
    no longer treats it as a structured section.
    Verified inside fortis-dev container with ROS Humble:
    colcon build --packages-select fortis_msgs fortis_safety fortis_comms fortis_arm fortis_drive => 5/5 OK
    colcon test --packages-select fortis_comms fortis_arm => 32 tests, 0 errors, 0 failures.
    [arm_controller_node.py]
2026-05-10 chore: scaffold fortis_description package (empty, ament_cmake)
    ament_cmake package with empty urdf/, meshes/, launch/, config/, and
    rviz/ directories plus install rules. Carries TODO markers explaining
    what eventually goes where. No URDF or xacro content -- real model is
    blocked on the OnShape export.
2026-05-10 chore: add scaffolding test stubs for safety+arm and bringup
    test_safety_arm_integration.py defines four skipped tests covering
    the arm-side mission-state gating contract (IDLE rejects, ARM_AT_VIEW
    accepts, ORBIT rejects, FAULT forces rejection). Mirrors the
    fortis_safety + fortis_drive integration test's contract surface for
    the arm.
    test_bringup_launch.py defines two skipped tests covering the
    fortis_bringup launch composition (required nodes alive, IDLE state
    reached). Lands ahead of the real bringup composition so the test
    seam is in place when the launch files stop being stubs.
    All six tests carry @pytest.mark.skip(reason="scaffolding only") and
    documented intent; no test bodies.
2026-05-11 docs(readme): refresh main README against FORTIS_FINAL_BOM
    Bring the top-level README into sync with the current BOM, scaffold state,
    and dev-environment plan:
    - Hardware table: ODrive S1 KIT, direct-drive M8325s on 48V CAN, AndyMark
    Dualie wheel spec, full arm joint stack (J1/J3 Cricket 25:1, J2 50:1
    planetary -- corrected from 20:1, J4 D845WP, ServoCity gripper), CL57T
    drivers, Teensy 4.1 motion controller, 5x Luxonis cameras with active
    focus, Jetson USB port assignments, chassis materials, and tether/no-
    battery + cable/winch deferral.
    - Repo layout: add fortis_bringup and fortis_description under src/,
    document firmware/teensy/ alongside docker/.
    - Dev environment: replace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
2026-05-11 docs(packages): align sub-package READMEs with FORTIS_FINAL_BOM
    - fortis_drive: add Hardware reference section pulling the AndyMark Dualie
    wheels, ODrive M8325s direct drive on 48V, ODrive S1 KIT, and CAN bus on
    Jetson USB Port 2 from the BOM. Reference-only -- the node itself
    doesn't change.
    - fortis_arm: rewrite the motion-controller and joint-reference blocks
    against the BOM: Teensy 4.1 replaces the Pololu Tics + PCA9685 plan,
    StepperOnline CL57T-V41 with explicit electrical envelope, 8-ch
    bi-directional bus transceiver in place of "SN74HCT245N", full part
    numbers for J1/J3 (17HS24-2104-ME1K + Cricket MK II 25:1), J2
    (CN-23HS22-2804-HG50-ME1K + 50:1 planetary + Ruland FHD-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
2026-05-11 feat(docker): add Isaac ROS GPU dev container (Dockerfile.dev-gpu)
    Adds the NVIDIA-GPU sibling of docker/Dockerfile.dev, FROM the Isaac
    ROS Dev Base for ros2_humble_release-3.2 (last 3.x supporting Humble).
    TARGETARCH-aware (x86_64 / aarch64) so the same Dockerfile builds on
    FORTIS PC, IdeaPad, and Jetson Orin Nano Super.
    Mirrors the CPU container's apt + pip layers exactly (moveit, ros2_control,
    robot_localization, foxglove_bridge, xacro, depthai, etc.) and pre-installs
    the Isaac ROS perception + motion stack via the official isaac-ros release-3
    apt repo: visual_slam, nvblox, image_proc, image_pipeline, cumotion,
    cumotion_moveit. Install step is non-fatal so a single missing binary does
    no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
2026-05-11 feat(docker): add docker-compose.gpu.yml overlay for fortis-dev-gpu
    Overlay compose file that adds the fortis-dev-gpu service on top of the
    existing docker/docker-compose.yml. Used as:
    docker compose -f docker/docker-compose.yml \
    -f docker/docker-compose.gpu.yml up
    Reserves an NVIDIA GPU via the modern deploy.resources.reservations.devices
    API (requires NVIDIA Container Toolkit on the host). Inherits the volume
    mounts, network/ipc/privileged flags, and ROS env vars from the CPU service
    rather than duplicating them.
    Does NOT modify docker/docker-compose.yml.
2026-05-11 fix(docker): make Dockerfile.dev base image configurable via BASE_IMAGE ARG
    Replaces the hard-coded `FROM osrf/ros:humble-desktop` with a defaulted
    ARG so the same Dockerfile can be reused across host architectures
    (e.g. building under an aarch64 Jetson host where a different base
    image tag is needed) without modifying the file. Default behavior
    unchanged: `docker build` with no build-args still pulls
    osrf/ros:humble-desktop.
2026-05-11 chore: add pre-commit hook configuration
    flake8 mirrors workspace .flake8 (max-line-length=99, sim/legacy
    excluded). pydocstyle replaces ament_pep257 with convention=pep257.
    Hygiene hooks (trailing whitespace, EOF, merge conflict, YAML) run
    on the full tree with build/install/log + binary asset dirs filtered.
    Python lint is scoped to src/**/*.py so research code under sim/
    and legacy/ stays excluded.
2026-05-11 chore: mirror ament_pep257 ignore list in pydocstyle hook
    ament_pep257 ships with a default ament_pep257.ini that ignores
    D203, D212, D404 (stylistic) and D100-D107 (missing-docstring family).
    The current codebase relies on that permissiveness, so the
    pydocstyle pre-commit hook needs the same add-ignore list to keep
    parity. Verified locally with pre-commit run --all-files: all hooks
    pass on the current tree.
2026-05-11 docs: pin verified post-refactor test count in README
    CI run on chore/ci-smoke-test (PR #3) reported 68 tests / 0 failures
    / 6 skipped on the new colcon test pass, down from the 126/0/8
    pre-refactor baseline. Pre-commit job (lint) ran in 14s, colcon
    build+test in 10m35s.
2026-05-11 docs(audit): add CLEANUP_AUDIT.md
    Comprehensive read-only audit of FORTIS package layout, dead code,
    upstream replacement candidates, and README drift. No source files
    deleted or modified. Top-of-document recommendation buckets sort
    findings into SAFE NOW (mostly README rewrites and one orphan
    config), SAFE AFTER UPSTREAM SWAP (the four legacy/ files), and
    LEAVE ALONE (state machine, gates, analysis writeups).
    Mechanical changes (Section 9) are tracked as separate commits.
2026-05-11 docs(audit): record clean pre-commit pass
    pre-commit run --all-files reported all 6 hooks Passed on the
    current tree with no rewrites. Section 9.1 of CLEANUP_AUDIT.md
    updated; no separate auto-fix commit needed.
2026-05-11 docs(readme): apply Section 5 drift fixes from cleanup audit
    Apply the README corrections documented in
    docs/CLEANUP_AUDIT.md Section 5:
    - Root README Status table: clarify that fortis_comms' motor/EKF
    helpers are in legacy/, that fortis_arm's action server is in
    legacy/, and that fortis_bringup's bringup.launch.py is live
    (sim/teleop remain stubs).
    - src/fortis_comms/README.md: drop motor_base/odrive_s1/ekf from
    the contents table (they moved to legacy/), fix the test table
    to reflect that test_ekf.py is an empty no-op module and
    test_imports.py no longer constructs an EKF, and trim the
    Migration / Known-issues sections that pointed at the deprecated
    files.
    - src/fortis_arm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
2026-05-11 chore(fortis_comms): remove orphan EKF config
    Delete src/fortis_comms/fortis_comms/cfgs/ekf_params.json and the
    empty cfgs/__init__.py marker, and drop the matching package_data
    block from setup.py. The consumer (ekf.py) was retired to
    legacy/deprecated_ekf/ weeks ago; the bundled config was no longer
    loaded by anything under src/. Description string updated to match
    what the package now ships (X-drive kinematics only).
    Per docs/CLEANUP_AUDIT.md Section 3 (Files not imported anywhere
    in src/) and the SAFE NOW bucket at the top of the audit doc.
    No tests touched. No production module imported these files, so
    the colcon test count is unaffected.
2026-05-11 fix(docker): pin Isaac ROS base to real NGC tags and add TARGETARCH
    The previous ARG defaults (x86_64-ros2_humble_release-3.2 /
    aarch64-ros2_humble_release-3.2) do not exist on nvcr.io/nvidia/isaac/ros.
    NGC publishes content-addressed hash tags with -amd64 / -arm64-jetpack /
    -arm64-fastos suffixes, not semver tags. Builds against the old defaults
    would 404 at FROM time.
    Repin to the real hash isaac_ros_28556f8bc78a98822bd08b2d7c6fcf9b
    (scanned 2026-04-30) and derive the per-arch tags from a single
    ISAAC_ROS_HASH ARG so future re-pins touch one line. Use -arm64-jetpack
    for arm64 (the Jetson runs JetPack OS; -fastos is for AMR appliances).
    The header comment block now documents the pinning p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
2026-05-11 docs(adr): note Isaac ROS hash-tagging and NGC auth requirement
    Update docs/adr/0001-dual-container-strategy.md to reflect the
    real Isaac ROS Dev Base tagging scheme on NGC (hash + arch + OS
    suffix, not semver) and to document the docker login nvcr.io
    prerequisite for the GPU build. Add a re-pin cadence note so the
    team knows when to bump ISAAC_ROS_HASH.
    docker/README.md updated alongside:
    - Prerequisites section calls out the NGC login.
    - "What's different" section reflects the hash-tag scheme instead
    of the fabricated *_release-3.2 names.
    - Multi-arch notes describe -amd64 / -arm64-jetpack and explain
    why -arm64-fastos is not used.
    - New "Re-pinning the Isaac ROS base image" section p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
2026-05-11 feat(urdf_cleanup): scaffold tool structure and parser
    Host-level dev tool that post-processes OnShape URDF exports into
    ROS 2 Humble-ready URDF. Lives in tools/urdf_cleanup/, not inside
    src/, because it runs at the host level on checked-out URDF
    artefacts and is not part of any colcon package.
    This commit lays down the package skeleton (__init__.py with the
    pipeline overview), the parser layer (UrdfDoc wrapper around
    lxml.etree with link/joint accessors, mutation helpers, and a
    pretty-printing serialiser), one minimal synthetic fixture URDF
    that mirrors the patterns we saw in the May 10 OnShape export
    (mangled __1__ suffixes, hanging_node_to_root joints, 1p5_spacer
    and open_cascade_step_tr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
    [minimal_export.urdf]
2026-05-11 feat(urdf_cleanup): link filtering and topology fixing
    LinkFilter (urdf_cleanup/link_filter.py): drops nuisance leaf links
    matching the patterns the May 10 FORTIS OnShape export ships
    (1p5_spacer*, part_<N>_<M>*, open_cascade_step_translator_*),
    together with the fixed joint attaching each one. Conservative:
    only fixed-joint attachments are removed, and any link with a
    non-fixed inbound joint or any outbound joint is preserved with a
    "load-bearing" note so the caller can audit. Extra patterns
    overrideable via the upcoming CLI --mapping config.
    TopologyFixer (urdf_cleanup/topology_fixer.py): rewires joints
    matching hanging_node_to_root_joint_<N> from the synthetic "root"
    node onto the chassi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
2026-05-11 feat(urdf_cleanup): renaming and ros2_control injection
    Renamer (urdf_cleanup/renamer.py): applies a flat mangled-name to
    clean-name mapping across <link> names, <joint> names, and their
    <parent>/<child> link references. Driven by a YAML/JSON config the
    CLI exposes via --mapping; the load_mapping_from_dict helper
    deserialises the schema. Unmapped names are recorded in the report
    rather than renamed by guesswork -- a clean failure is better than
    silently renaming a load-bearing joint.
    Ros2ControlInjector (urdf_cleanup/ros2_control.py): appends a
    <ros2_control name="fortis_drive_hw" type="system"> block to
    <robot>, populating it with one <joint> entry per wheel revolute /
    continuous joint car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
2026-05-11 feat(stack): add stack CLI + .env.example
    Adds an executable ./stack at the repo root that wraps git + docker compose
    so common deployment workflows (bring up, tear down, branch flip on the
    Jetson, exec into the dev container) are one-line operations. Bash only,
    no Python or npm deps; the script is a thin convenience layer over the
    existing docker/docker-compose.yml + docker-compose.gpu.yml setup.
    Commands: up, down, pull, restart, rebuild, logs, exec, status, switch,
    ssh, help. Reads configuration from .env in the repo root (template:
    .env.example); .env is gitignored.
2026-05-11 test(stack): add bash test suite for stack CLI
    Covers help / dispatch / status / switch / exec defaults. Uses a plain-bash
    runner (tools/stack/tests/run_tests.sh) with mocked git/docker/ssh on PATH,
    so tests never touch real containers or remote state. Documents an optional
    bats-core fallback that does not require a system install.
2026-05-11 feat(urdf_cleanup): launch + rviz generation and mesh renaming
    MeshRenamer (urdf_cleanup/mesh_renamer.py): walks every <mesh> in
    the cleaned URDF, derives a clean mesh basename from the enclosing
    <link>, rewrites the filename attribute, and optionally copies the
    .stl from input_meshes_dir into output_meshes_dir. Collision
    detection for two meshes sharing one link is handled with a
    warning rather than a silent overwrite. Tolerant of meshes that
    have no enclosing link or whose source file is missing on disk;
    those cases warn and skip rather than crash.
    generate_display_launch (urdf_cleanup/launch_generator.py): writes
    a ROS 2 Humble display.launch.py that spawns robot_state_publisher
    (with th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
2026-05-11 docs(stack): tool README + repo README dev-env update
    Adds tools/stack/README.md with the full command reference, Jetson and
    dev-desk workflows, troubleshooting table, and the raw docker compose
    fallback for when the wrapper is unavailable. Adds a short subsection to
    the repo README's "Dev environment" pointing at ./stack as the preferred
    entry point while leaving the existing raw docker compose snippet intact.
2026-05-11 feat(urdf_cleanup): end-to-end tests and CLI
    main.py: top-level argparse CLI exposing the full pipeline as
    "python -m urdf_cleanup --input <dir|urdf> --output <dir>
    [--mapping config.yaml] [--verbose]". Resolves --input as either
    a directory containing one .urdf (with meshes/ alongside) or a
    single .urdf file (with meshes/ alongside the parent). Loads the
    default FORTIS chassis mapping from configs/ next to the package
    when --mapping is omitted; tolerates a missing mapping by leaving
    mangled names in place and recording them as unmapped.
    Pipeline order matters: TopologyFixer runs BEFORE Renamer. The
    topology pass matches hanging_node_to_root_joint_* by their
    original mangled names, so renam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
    [realistic_export.urdf]
2026-05-11 docs(urdf_cleanup): README + FORTIS default mapping config
    README documents the pipeline (parser -> link_filter ->
    topology_fixer -> renamer -> ros2_control -> mesh_renamer ->
    launch_generator + rviz_generator), quickstart, mapping schema,
    CLI flags, test layout, and the explicit limitations (naming +
    topology only; CAD errors out of scope; arm URDF hand-authored
    elsewhere).
    The default FORTIS chassis mapping config was added in the prior
    commit (configs/fortis_chassis_mapping.yaml). Schema documented
    in the README.
2026-05-13 feat(fortis_description): hand-written primitives URDF; drop urdf_cleanup tool
    Replace placeholder fortis_description with a hand-written xacro tree of
    primitives (no meshes), built from the ROS_Expanded_Chassis CAD as truth.
    25 links, single rooted tree, no orphans (verified via check_urdf).
    Adds:
    urdf/fortis_{robot,chassis,arm,constants,inertia,materials}.{urdf.,}xacro
    launch/display.launch.py (RViz + jsp_gui)
    launch/foxglove.launch.py (RSP + jsp_gui + foxglove_bridge)
    rviz/fortis.rviz (minimal layout)
    Removes tools/urdf_cleanup: superseded by the hand-written description.
    The OnShape-export-cleanup pipeline is no longer the source of truth.
    Build ver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
    [fortis_arm.urdf.xacro, fortis_chassis.urdf.xacro, fortis_constants.xacro, fortis_inertia.xacro, fortis_materials.xacro, fortis_robot.urdf.xacro, minimal_export.urdf, realistic_export.urdf]
2026-05-13 chore(sim): untrack deprecated/results CSV dumps (-57 MB)
    The 182 result files under sim/isaac/xdrive/deprecated/results/ were
    frozen experimental data from superseded sweeps (orbit_torque*,
    arm_continuous_sweep_v1..v3, orbit_realwheel_singlesphere, etc.) and
    made up ~81% of the tracked repo. Active sweep results stay in
    sim/isaac/xdrive/results/.
    Removed from tracking and added a .gitignore rule so they cannot drift
    back in. Files remain retrievable via git history.
    Two narrative references in sim/isaac/xdrive/results/orbit_realwheel_5sphere/RESULTS.md
    and sim/isaac/xdrive/deprecated/README.md describe historical moves and
    are intentionally left as-is.
    [24in_bare_flat.csv, 24in_bare_flat_filtered.csv, 24in_bare_reactor.csv, 24in_bare_step.csv, 24in_bare_step_filtered.csv, 24in_loaded_flat.csv, 24in_loaded_flat_filtered.csv, 24in_loaded_reactor.csv]
2026-05-13 chore: move analysis/ under sim/
    The five drivetrain writeups (orbit, pivot, skid-steer rejection,
    torque, x-drive) are all sim-derived. Colocating them with sim/ keeps
    the design rationale next to the code that produced the numbers and
    removes a top-level directory whose scope was ambiguous.
    README.md updated in two places.
2026-05-13 chore(docs): drop CLEANUP_AUDIT.md and unhook README references
    The audit was a time-stamped 466-line agent snapshot ("Generated
    2026-05-11", branch chore/cleanup-audit) with rotting line counts and
    file paths. The genuinely useful parts -- the legacy/ migration plan
    and what each legacy/deprecated_* subdir is waiting on -- already live
    in legacy/README.md and src/fortis_comms/README.md.
    Unhooked the three references that pointed at it:
    - README.md line 166 (fortis_comms status row)
    - src/fortis_drive/README.md line 30 (odrive migration note)
    - src/fortis_comms/README.md line 5 (legacy helpers note)
    docs/ now contains only docs/adr/.
2026-05-20 feat(fortis_description): add stow-offset kinematics, motor visuals, transverse camera
    Arm chain is no longer treated as co-linear. Adds the lateral 'stow offsets'
    along each joint's rotation axis (local Y) that let the arm fold flat into
    its stowed pose without segments intersecting. Values back-computed from CAD:
    J2 -> J3: y = -0.073 m (chassis-right per REP-103)
    J3 -> J4: y = +0.052 m (zigzag flip to chassis-left)
    J4 -> EE: y = 0.000 m (~11 mm in CAD, treated as noise)
    arm_link*_axis values now hold the X projection (tube length), not the
    3D axis-to-axis distance. Total 3D distance = sqrt(X^2 + offset_y^2).
    Tube visuals yaw to span the diagonal between successive joint axes
    (a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
    [fortis_arm.urdf.xacro, fortis_constants.xacro]
2026-05-20 fix(comms): align xdrive_kinematics with URDF wheel origins
    LEN_X and LEN_Y had been carrying placeholder values (4.405 in,
    6.462 in) copied from the senior-design module. The locked URDF in
    fortis_description has the wheel joints at 0.176 m and 0.125 m from
    base_link (wheel_x_offset, wheel_y_offset in fortis_constants.xacro,
    applied symmetrically by the omni_wheel macro). Pure translation
    commands were unaffected; the rotation column of the H matrix uses
    (LEN_X + LEN_Y) as a single lever arm, so omega commands were scaled
    about 9 percent off.
    Switch LEN_X and LEN_Y to meters directly, mirror the URDF values
    verbatim, and add a header block naming the source file and lock
    date. Drop the IN_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
    [xdrive_kinematics.py]
2026-05-20 test(comms): add URDF-kinematics drift regression
    Parse fortis_description/urdf/fortis_constants.xacro as plain XML and
    assert that LEN_X, LEN_Y, and WHEEL_RADIUS in the kinematics module
    match the URDF wheel constants to within 1e-4 m. Also parse
    fortis_chassis.urdf.xacro and assert the four omni_wheel invocations
    place wheels at all four sign combinations of (+/- wheel_x_offset,
    +/- wheel_y_offset). The test does not depend on xacro or rclpy and
    runs under colcon test or bare pytest with PYTHONPATH=src/fortis_comms.
    This bites the moment either side drifts. Dry-run proof: setting
    LEN_X = 0.999 in xdrive_kinematics.py before commit produced
    AssertionError: LEN_X (0.999 m) drifted from U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
2026-05-20 docs(comms): document drift invariant
    Replace the stale "Chassis dimension note" section (which had been
    flagging 4.405 in / 6.462 in as a deferred calibration question)
    with a "Drift invariants" section that names the three constants
    coupled to the URDF, points readers at the new regression test, and
    calls out the unresolved H-matrix sign convention question as a
    separate task that must land before real-robot bring-up.
    Also add the new test file to the test table.
2026-05-21 docs(safety): rewrite README to spec
    Existing README covered topics and the CONTEXT_FIELDS footgun but did
    not enumerate the 9-state allowlist gating, the 15 events, or the FSM
    decision rules. Rewrite to add:
    - Per-state table with Drive-allowed and Arm-allowed columns matching
    the gates fortis_drive and fortis_arm apply.
    - Full list of Event enum names.
    - Decision rules section: first-match-wins ordering, wildcard FAULT,
    RESET requires operator_ack.
    - Topic table with explicit QoS notes.
    - try_step vs step rationale.
    - Mermaid diagram export instructions.
    Kept the CONTEXT_FIELDS duplication footgun note and the scope
    exclusion section from the previous README.
2026-05-21 test(integration): replace safety-arm scaffold with gripper-services tests
    The previous test_safety_arm_integration.py was a 4-method scaffold of
    @pytest.mark.skip stubs aimed at a MoveToPose action server that has
    since been retired to legacy/deprecated_arm_action. The arm controller
    exposes std_srvs/Trigger gripper services today; this commit replaces
    the scaffold with 10 live unittest methods mirroring the safety-drive
    integration pattern.
    Coverage:
    - test_00 pins ALLOWED_ARM_STATES so a single-line failure surfaces
    any allowlist drift.
    - test_01..test_04 walk the FSM into IDLE, ORBIT, TARGETING, and
    FAULT and assert both open_gripper and close_gripper return
    success=False with the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
2026-05-21 feat(bringup): fill teleop.launch.py with teleop_twist_keyboard
    Replace the TODO stub that just LogInfo-printed "not implemented" with
    a real launch that loads teleop_twist_keyboard and explicitly remaps
    its output to /cmd_vel. The remap is a no-op against the package's
    current default (teleop_twist_keyboard publishes to /cmd_vel out of
    the box) but makes the wiring explicit so a future default change or
    package rename does not silently break it.
    Documented in the header that this is the developer / debug path, not
    the production operator UI (which is Foxglove + click-to-3D), and
    called out the stdin-must-be-a-tty limitation that bites if the
    launch is backgrounded or run via an IDE play bu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
2026-05-21 feat(bringup): scaffold sim.launch.py for Isaac Sim integration
    Replace the TODO stub with a real ROS-side launch that publishes the
    URDF, fills in a zero-pose /joint_states by default, and exposes a
    Foxglove WebSocket bridge.
    What it brings up:
    - robot_state_publisher with the xacro-expanded fortis_robot URDF.
    - joint_state_publisher (no GUI) so the URDF renders without an
    external joint source. Disable via publish_joint_states:=false when
    Isaac Sim is streaming /joint_states; running both produces a fight
    on the topic.
    - foxglove_bridge on configurable port (default 8765).
    What it deliberately does NOT do:
    Spawn Isaac Sim. Isaac Sim runs on the Windows host outside the dev
    containe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
2026-05-21 feat(bringup): populate bringup_params.yaml with defaults
    Replace the empty placeholder with three documented per-node blocks
    (mission_state_node, drive_node, arm_controller) and wire
    bringup.launch.py to load it via Node(parameters=[bringup_params]).
    Today no fortis_* node calls declare_parameter(): per the explicit
    rationale in src/fortis_drive/README.md "Parameters" section, the
    module-level constants were left in code to make accidental override
    impossible. Loading this YAML against undeclared parameters is a
    no-op in ROS 2 Humble: the parameter registers but no code reads it.
    The file is forward-looking documentation that becomes load-bearing
    the moment a node adopts declare_parameter(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
    [bringup_params.yaml]
2026-05-26 feat(fortis_description): in-line arm, new gripper, camera fixes
    Arm geometry:
    - Drop all lateral stow offsets (j2_offset_y, j3_offset_y, j4_offset_y);
    arm chain is now fully in-line. EE lands on the J1 axis when arm is folded
    forward, matching the way the previous offsets were already cancelling out.
    - Update arm dimensions: J2->J3 = 0.3939 m (15.508 in), J3->J4 = 0.2992 m
    (11.781 in), J4->gripper-base = 0.0635 m / 0.02286 m (2.5 in / 0.9 in
    Z lift), J1->J2 = 0.0559 m (2.199 in).
    - Sink the J1 motor body into the chassis (cylinder extends below
    arm_mount instead of above) so link1 starts flush with chassis top.
    - Yaw the arm 180 deg at the chassis_to_arm_mount fixed joint so the a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
    [fortis_arm.urdf.xacro, fortis_chassis.urdf.xacro, fortis_constants.xacro]
2026-05-26 vendor(teensy): add TeensyStep4 library (luni64 @ 42e1f69)
    Vendored from https://github.com/luni64/TeensyStep4 commit 42e1f69 (2023-11-14). TeensyStep4 is the Teensy-4-specific successor to the original TeensyStep library, which is effectively abandoned for IMXRT1062 hardware. Replaces HANDOFF S8.1 option-1 plan (vendor patched TeensyStep) with the upstream-supported alternative.
2026-05-26 feat(teensy): adapt firmware to TeensyStep4 API; rename main.ino -> teensy.ino
    - Switched include from <TeensyStep.h> to <teensystep4.h>
    - Added 'using TS4::Stepper / StepperGroup' so existing identifiers compile
    - Replaced StepControl g_motion with StepperGroup g_motion{g_j1,g_j2,g_j3}
    - Added motionRunning() helper (group has no isRunning, OR each isMoving)
    - Replaced g_motion.moveAsync(...) with g_motion.startMove()
    - Added TS4::begin() in setup() (required by TeensyStep4)
    - Moved MOCK_MODE define above includes so #if !MOCK_MODE gates TeensyStep
    - Wrapped TeensyStep include + stepper declarations in #if !MOCK_MODE per HANDOFF S8.1
    - Renamed main.ino -> teensy.ino so Arduino IDE accepts t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
    [teensy.ino]
2026-05-26 docs(teensy): mark TeensyStep4 swap + bench flash as verified in HANDOFF S7
    Updates the verification status table to reflect:
    - Arduino IDE compile path passes (used in place of arduino-cli)
    - Real Teensy 4.1 successfully flashed
    - 8 Hz LED blink confirms firmware in watchdog-fault state (expected, no host)
    - EVT_BOOT + EVT_FAULT frames observed on USB serial @ 1 Mbaud
    - Constant-consistency line updated for the main.ino -> teensy.ino rename
    S10 step 2 of the bring-up sequence is complete.
    S8.1 blocker (TeensyStep -> TeensyStep4) is resolved.
2026-05-26 test(teensy): add standalone servo sweep sketch under tests/servo_sweep/
    Bench tool: drives a single hobby servo on pin 28 (J4) with the firmware's
    PWM range, sweeps slowly between min and max, prints us= to USB Serial
    @ 1 Mbaud (same baud as the main firmware so the same Serial Monitor
    session works for both).
    Used today to:
    - confirm pin 28 + pin 29 both generate valid PWM via Servo.h on Teensy 4.1
    - find the safe us range of the physical J4 D845WP servo (the next commit
    pulls these calibrated values back into teensy.ino)
    Bound for `firmware/teensy/tests/`, not the main sketch tree, so Arduino IDE
    treats it as a separate sketch and doesn't risk being uploaded by mistake.
    [servo_sweep.ino]
2026-05-26 calib(teensy): narrow J4 (D845WP) us range from 500-2500 to 800-2000
    Hitec spec for the D845WP is 500-2500 us, but the physical servo unit
    we're shipping with stalls (current spikes on the bench supply) below
    ~700 us and above ~2000 us. Commanding past the mechanical endstops
    overdraws current and stresses the gearbox.
    Calibration done on 2026-05-20 using tools/servo_sweep at 6.0 V / 2.0 A.
    100 us margin pulled in on the low end, 0 us on the high.
    If the J4 servo is ever physically replaced, re-run the sweep test and
    update these constants. Other D845WPs of the same model can vary.
    Affects:
    - kJ4MinUs / kJ4MaxUs definitions
    - g_j4_servo.attach() in setup() (uses the same constants)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
    [teensy.ino]
2026-05-26 feat(teensy): CMD_HOME_REQUEST now handles J4 servo (PROTO_MINOR 0->1)
    Implements the J4 (mask bit 3) branch of CMD_HOME_REQUEST. A servo always
    knows its absolute position from the PWM pulse it receives, so homing
    is just commanding the calibrated stowed pose -- no ALM/back-off step
    needed.
    Preconditions enforced before any bit is acted on:
    - g_state.fault_flags == 0 (else NAK ERR_FAULT_ACTIVE)
    - STATE_ENABLED (else NAK ERR_DISABLED)
    - mask != 0 (else NAK ERR_BAD_PARAMETER)
    Mask handling:
    - bits 0..2 (J1/J2/J3 steppers) -> NAK ERR_NOT_IMPLEMENTED (HANDOFF S9)
    - bit 3 (J4 servo) -> move to kJ4HomeUs, then ACK
    - bit 4 (gr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
2026-05-26 test(teensy): add J4 home-command demo sketch
    Standalone bench tool that mirrors handleHomeRequest J4 branch (mask bit 3) WITHOUT needing Nikhil's host-side bridge to exist yet.
    Cycle: drives J4 to an offset (800 us, then 1900 us), waits, fires the home routine -> snaps to kJ4HomeUs (1000 us), waits, repeats. Pass = J4 visibly snaps to 1000 us on each home event.
    Constants mirror teensy.ino's J4 calibration:
    kJ4MinUs = 800 (safe floor)
    kJ4MaxUs = 2000
    kJ4HomeUs = 1000 (FORTIS stowed pose)
    Lives under firmware/teensy/tests/home_j4_demo/ so Arduino IDE treats it as its own sketch.
    [home_j4_demo.ino]
2026-05-26 fix(teensy): correct level-shifter handling for TXS0108E (was SN74HCT245N)
    Hardware actually shipped with a TI TXS0108E 8-bit bidirectional auto-direction translator (marking YF08E), not the SN74HCT245N the firmware was written against. The two chips are NOT drop-in: TXS0108E has active-HIGH OE (HCT245 is active-LOW) and has no DIR pin (HCT245 has one).
    Behavior changes:
    - PIN_HCT245_OE_N renamed PIN_LS_OE; polarity flipped
    old (HCT245): LOW = enabled, HIGH = Hi-Z
    new (TXS): HIGH = enabled, LOW = Hi-Z
    - PIN_HCT245_DIR removed entirely; TXS0108E has no DIR pin, so pin 15 is
    now unused/reserved (constant kept as a commented-out marker so the
    history is traceable)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
    [teensy.ino]
2026-05-26 docs(teensy): update PROTOCOL + HANDOFF for TXS0108E level shifter
    Matches the firmware change in the previous commit.
    PROTOCOL.md:
    - Hardware overview: SN74HCT245N -> TXS0108E (active-HIGH OE, no DIR)
    - Logic-levels bullet rewritten with TI datasheet reference + open-drain
    note (1.2 Mbps cap; well above our ~64 kHz STEP rate)
    - Pin map: pin 14 now 'Level-shifter OE (active-HIGH)', pin 15 marked
    reserved
    - Driver-alarm wiring section: second shifter is also TXS0108E, no DIR
    needed
    - Closing note: any active-HIGH OE auto-sense translator works
    (TXB0108 explicitly called out as a push-pull drop-in alternative)
    HANDOFF.md:
    - Hardware table updated: TXS0108E with ma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
2026-05-26 fix(teensy): wire readMcuTempC10 to tempmonGetTemp (HANDOFF S9 TODO)
    The stub used to return 0 unconditionally, which meant RSP_STATUS reported
    0.0 C and FAULT_OVER_TEMP could never trip. tempmonGetTemp() is provided
    by Teensyduino 1.5x+ for IMXRT1062 -- no extra include needed.
    NaN guard: the on-die temp monitor briefly returns NaN at boot before it
    stabilises. We treat that as 0 (unknown / cold) so a stale NaN can't cast
    to a garbage int and accidentally trip the 85 C over-temp threshold.
    MOCK_MODE keeps the original 0 stub so desktop builds don't need the
    Teensy core.
    No callers needed updating -- signature and units (int16_t, 0.1 C) are
    unchanged. Affects RSP_STATUS payload byte 24-25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
    [teensy.ino]
2026-05-26 fix(mock): defer heartbeat watchdog until first inbound CMD (HANDOFF S8.2)
    The watchdog used to arm itself the moment MockState was constructed,
    which meant a host that took more than 250 ms to attach to the pty would
    see a spurious EVT_FAULT(HEARTBEAT_TIMEOUT) frame before its first
    command even left the wire.
    Fix per HANDOFF S8.2:
    - MockState.last_heartbeat is now Optional[float] (None until first CMD)
    - tick() skips the timeout check while last_heartbeat is None
    - existing _handle() setter (line 343) already arms on every inbound
    CMD, so no setter change needed
    - docstring updated to say 'armed by first inbound CMD'
    Verified: python -m py_compile passes. Behavior of a long-r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
2026-05-28 feat(fortis_control): odrive_ros2_control integration for X-drive
    Brings the X-drive stack to first-light: drive_node now publishes into
    a velocity_controllers/JointGroupVelocityController loaded by
    controller_manager, which drives the four ODrive S1s over CAN via the
    upstream odrive_ros2_control hardware plugin.
    - New fortis_control package: full-chassis + bench-one-motor launches,
    matched controller_manager YAMLs.
    - New fortis_chassis.ros2_control.xacro: <ros2_control> system block
    parametrised by wheels list and use_mock_hardware fallback for CI.
    - fortis_drive: adds /wheel_velocity_controller/commands publisher in
    [fl, fr, rl, rr] order; on rejection publishes zeros so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
    [fortis_chassis.ros2_control.xacro, fortis_drive_controllers.yaml, fortis_drive_controllers_bench.yaml, fortis_robot.urdf.xacro]
2026-05-28 feat(tools): one-command ODrive USB passthrough for Windows + WSL2
    Calibration in fortis-dev on Windows + WSL2 needs the S1 forwarded from
    the Windows host with usbipd-win. Docker can't reach across the WSL2
    boundary (privileged: true is already doing the most it can), so this is
    a host-side helper plus a container-side sanity check.
    - tools/attach-odrive.ps1: parses usbipd list, binds if needed, attaches
    to WSL. Idempotent across replug/reboot.
    - tools/check-odrive-usb.sh: confirms /dev/ttyACM* visible from inside
    WSL/the container; prints the exact recovery command if not.
    - tools/odrive_calibrate.md: new "Prerequisite: USB passthrough on
    Windows + WSL2" section pointing at both, ah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
2026-05-28 docs(odrive_calibrate): allow bare-shaft calibration without brake resistor
    Bare-shaft calibration (no wheel, no load, low speeds) generates little
    enough regen that the bus cap handles it without a brake resistor wired.
    The scope is strict: every step in this runbook is allowed; nothing in
    fortis_control/README.md is. Document the config override and call out
    the re-config required before moving past calibration.
2026-05-28 fix(odrive): harden calibration config + reorder CAN chain to FL→FR→RR→RL
    Calibration shakeout from 2026-05-27 bench session — all four S1s now
    calibrated. Two distinct concerns landed in one commit:
    1) Hardened canonical config block in tools/odrive_calibrate.md:
    - pole_pairs = 20 (M8325s 100KV datasheet, authoritative).
    - calibration_current and calibration_lockin.current = 20 (half of
    continuous current per ODrive setup wizard; was 10).
    - Pre-populate phase_resistance = 0.024, phase_inductance = 9.9e-6,
    and set both _valid flags True. Bypasses firmware auto-measurement
    during MOTOR_CALIBRATION, which was producing false
    ERROR_UNBALANCED_PHASES on the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
    [fortis_chassis.ros2_control.xacro]
2026-05-28 refactor: rename BL/BR → RL/RR end-to-end across drive pipeline
    Kills the naming inconsistency that had a legacy "BL/BR" (back-left /
    back-right) convention in the kinematics module + WheelVelocities
    message coexisting with an "RL/RR" (rear-left / rear-right) convention
    in the URDF, ros2_control YAML, controllers, and tests. The boundary
    relabel hack in drive_node._wheel_command_to_controller_array (which
    swapped names but not values when serialising the controller array)
    is gone — every consumer now uses one canonical naming, end-to-end.
    Files renamed:
    - src/fortis_msgs/msg/WheelVelocities.msg: fields bl/br → rl/rr +
    comment.
    - src/fortis_comms/fortis_comms/xdrive_kinematics.py: H-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
    [test_drive_node.py, xdrive_kinematics.py]
2026-05-28 fix(ci): unblock pre-commit lint on main
    CI has been red for 3 consecutive commits (since Cesar's PR landed)
    because the pre-commit (lint) job fails before the test phase. Five
    distinct issues, all addressed here:
    - Pre-commit was linting Cesar's vendored TeensyStep4 library under
    firmware/teensy/lib/, which has its own conventions. Added that path
    to the global exclude list in .pre-commit-config.yaml so we lint only
    FORTIS-authored code.
    - flake8 F401 on src/fortis_control/test/test_bench_launch.py: removed
    unused `launch` and `launch_ros.actions` imports (residue from the
    initial scaffold; the test actually uses `launch_testing.actions`).
    - flake8 F401 on src/fortis_control/test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
2026-05-28 feat(safety): ODrive error surfacing into mission FSM
    Closes the open ADR 0002 follow-up about ODrive S1 disarm / undervoltage /
    overcurrent events not propagating into ros2_control. The upstream
    odrive_ros2_control plugin remains silent on these (per its README); we
    work around it with a small, decoupled FORTIS-internal contract.
    What lands:
    - fortis_msgs:
    - new OdriveAxisHealth.msg: per-axis snapshot (node_id, armed flag,
    active_errors bitfield, vbus, motor + FET temperatures).
    - new OdriveHealth.msg: composite of four OdriveAxisHealth (fl, fr,
    rl, rr) + stamp. The bridge from upstream /odrive_status into this
    message is the only thing that has to track upstream-schema ch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
2026-05-28 docs: sync post-landing state — sim/teleop live, teensy.ino, S8.1 resolved
    Cleanup pass after recent landings: documentation no longer claims work
    that's already done. Five files touched:
    - README.md (top-level): the fortis_bringup row stated sim.launch.py +
    teleop.launch.py were still TODO stubs. They've shipped — sim brings
    up robot_state_publisher + joint_state_publisher + foxglove_bridge,
    teleop brings up teleop_twist_keyboard with /cmd_vel remap. The row
    also now mentions the new odrive_health_monitor_node in the bringup
    composition.
    - src/fortis_bringup/README.md: rewrote the launch-files table, the
    config table, the usage examples, and the TODO list. Stale "stub:
    lo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
    [bringup_params.yaml]
2026-05-28 chore: strip deprecated/legacy mentions from active surface, kill dead files
    Active READMEs were carrying ~20 sentences explaining what got moved to
    legacy/, what scaffolds got retired, and what's deferred. Per policy:
    active docs describe current shape; historical context belongs in git
    log and legacy/README.md. Same for active source docstrings — they
    were paraphrasing decisions that are now embedded facts.
    Files deleted outright (not preserved as legacy reference — no value
    as reference):
    - tools/attach-odrive.ps1 abandoned Windows-USB-passthrough script
    - tools/check-odrive-usb.sh companion to attach-odrive.ps1
    - src/fortis_comms/test/test_ekf.p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
2026-05-28 chore: delete docs/ ADRs, strip references from active surface
    Two ADRs lived under docs/adr/ — both prose, no functional dependency in
    code, runtime, or build. Deleted outright. References in active files
    rewritten to describe the current shape without the "See docs/adr/..."
    pointer:
    - README.md: removed docs/adr/ from the repo-layout block and the
    Documentation section; rewrote the fortis_control row to describe
    the package directly instead of deferring to an ADR.
    - docker/docker-compose.gpu.yml: stripped the ADR reference from the
    GPU-overlay header comment.
    - docker/Dockerfile.dev-gpu: stripped the ADR reference from the
    Isaac-ROS apt-install layer comment.
    - docker/README.md: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
2026-05-30 feat(drive): UI arm/disarm via drive_enable_node + layout buttons
2026-05-30 docs(runbook): UI arm via ARM DRIVE button
2026-05-31 docs(tuning): ODrive velocity-loop tuning runbook for X-drive staggered-start fix
2026-05-31 feat(drive): wheel-direction signs + cmd_vel watchdog + stop-on-gate-close
    - WHEEL_DIRECTION (+1,-1,+1,-1) inverts mirror-mounted right-side motors (FR,RR)
    - /cmd_vel dead-man watchdog: zeros after CMD_VEL_TIMEOUT_S so teleop release stops the robot
    - zero immediately on leaving a driving state so STOP halts the wheels
    - tests updated for signed output + new watchdog/stop/direction coverage
    [test_drive_node.py]
2026-05-31 fix(ci): testable cmd_vel watchdog + integration signs; add ./stack build + foxglove URDF
    drive_node cmd_vel_timeout_s is now a constructor arg so gating tests use a large value and the watchdog test a small one (CI is speed-independent). Integration tests apply WHEEL_DIRECTION and publish cmd_vel continuously to keep the watchdog fresh. stack gains a build subcommand (colcon build in container). Foxglove layout adds a URDF layer to the 3D panel and renames ARM/DISARM to ENABLE/DISABLE DRIVE.
    [test_drive_node.py]
2026-05-31 fix(drive): negate Vx for FORTIS front=-X (forward was driving backward)
    A forward /cmd_vel drove toward base_link +X, but FORTIS front is base_link -X, so forward went backward. Add CMD_VEL_FRAME_SIGN at the drive boundary (negate Vx; Vy/wz unchanged pending strafe verification on the robot). H matrix stays pure base_link kinematics. Tests mirror the frame sign; the direction test now asserts the left/right inversion pairing (convention-independent).
    [test_drive_node.py]
2026-05-31 feat(perception): front chassis OAK-D Lite bring-up (RGBD + IMU to Foxglove)
    depthai_ros_driver-based bring-up for the single front OAK-D Lite:
    - fortis_bringup launch includes the driver camera.launch.py, tied to the
    URDF front_camera_link, with the colored RGBD point cloud enabled
    - config pins the front camera by MXID and sets 480p depth-aligned stereo
    - new Foxglove layout: RGBD cloud + image panel + IMU plot
    - Dockerfile.dev: install ros-humble-depthai-ros
    - docker-compose: bind /dev/bus/usb for OAK / USB-CAN passthrough
    - package.xml: declare depthai_ros_driver exec dependency
    Node graph loads and reads the camera MXID on hardware. Live streaming on a
    Windows PC is blocked by the kn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
2026-05-31 docs: document front OAK-D Lite bring-up
    Refresh existing READMEs for the oak_chassis_front camera bring-up
    (no new doc files):
    - fortis_bringup README: launch + config table rows, run line, updated
    the OAK camera TODO (front done, 3 cameras + arm still pending)
    - top-level README: fortis_bringup status row
    - docker README: depthai-ros install + /dev/bus/usb passthrough note
2026-05-31 refactor(comms): extract latched_qos_profile() factory (audit #1)
    The depth=1 / TRANSIENT_LOCAL / RELIABLE "mission_state contract" QoS was
    hand-rolled in 6 nodes, each with comments warning that any drift silently
    breaks DDS discovery. Centralize it as
    fortis_comms.qos_profiles.latched_qos_profile() and call it from all six:
    - fortis_safety: mission_state_node, event_console, odrive_health_monitor
    - fortis_drive: drive_node, drive_enable_node
    - fortis_arm: arm_controller_node
    Adds fortis_comms as a dep of fortis_safety (fortis_drive / fortis_arm
    already depend on it). Test files keep their own inline QoS as the
    independent contract spec; a new unit test asserts the helper's field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
    [arm_controller_node.py, qos_profiles.py]
2026-05-31 docs(bringup): correct stale cmd_vel watchdog comment (audit #6)
    bringup_params.yaml claimed the cmd_vel watchdog was "Not implemented
    yet", but it shipped in 588daf6 (drive_node CMD_VEL_TIMEOUT_S). Update the
    comment to state it IS implemented (as an in-code constant, not read via
    declare_parameter) so the next operator isn't misled into thinking the
    safety feature is absent or that the YAML value tunes it.
    [bringup_params.yaml]
2026-05-31 refactor(control): collapse bench launch into parameterized drive_hw (audit #7)
    drive_hw.launch.py and bench_one_motor.launch.py were ~95% identical,
    differing only in the wheel set and the controllers YAML. Parameterize
    drive_hw with `wheels` (default fl,fr,rl,rr) and `controllers_file`
    (default fortis_drive_controllers.yaml), and make bench a thin
    IncludeLaunchDescription of it (wheels:=fl, the bench YAML).
    Production drive_hw is byte-identical via the defaults; the existing
    test_bench_launch integration test now exercises the shared launch path,
    so the bench and production bring-ups can no longer drift in spawner
    ordering or plugin wiring.
2026-05-31 docs(camera): note depthai-ros v2 param names + v3 rename map
    oak_chassis_front.yaml uses depthai-ros v2 (ros-humble-depthai-ros) param
    names, runtime-verified on hardware. Add a header note mapping them to the
    v3 renames (i_mx_id -> i_device_id, i_resolution -> i_width/i_height,
    i_align_depth -> i_aligned, i_pipeline_type -> pipeline_gen.i_pipeline_type)
    because ROS silently ignores unknown params, so a v3 driver upgrade would
    otherwise read this file as defaults with no error. Comment-only; no
    behavior change.
    [oak_chassis_front.yaml]
2026-05-31 feat(perception): migrate front OAK-D Lite to depthai-ros v3
    Move the front chassis camera bring-up from the v2 depthai-ros driver to v3
    (ros-humble-depthai-ros-v3, from the ROS 2 testing apt repo):
    - launch: include depthai_ros_driver_v3 driver.launch.py (was
    depthai_ros_driver / camera.launch.py); parent_frame stays front_camera_link
    - config: v3 param dialect -- driver.i_device_id (was camera.i_mx_id),
    pipeline_gen.{i_pipeline_type: rgbd, i_enable_rgbd, i_nn_type, i_enable_imu},
    stereo.{i_aligned, i_subpixel, i_depth_preset}, rgb/left/right i_width/i_height
    - Dockerfile.dev: install ros-humble-depthai-ros-v3 (v2 removed; the v2 core
    file-conflicts with v3)
    - Dockerfile.dev-gpu: a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
2026-05-31 fix(docker): make ./stack build the right per-arch/device image
    Two bugs blocked `./stack rebuild` on the arm64 Jetson:
    1. Dockerfile.dev-gpu's `FROM base-${TARGETARCH}` got an empty TARGETARCH
    because `docker compose build` (unlike `docker buildx build`) does not
    auto-populate the predefined TARGETARCH buildarg -> stage name "base-",
    invalid reference. Fix: ./stack exports TARGETARCH from
    `dpkg --print-architecture` and docker-compose.gpu.yml passes it as a
    build arg.
    2. The gpu profile composes both -f files, so the cpu `dev` service (x86-only
    osrf/ros:humble-desktop base) was also built on arm64 -> exec format error.
    Fix: profile-gate the services (dev -> [cpu], for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
2026-05-31 fix(docker): arm64 dev image uses a Humble base, not the Noble Isaac base
    The Jetson's GPU/Isaac base (Dockerfile.dev-gpu, arm64-jetpack) resolves to
    Ubuntu 24.04 (Noble) / Isaac ROS 4.x, which has NO ros-humble-* packages --
    incompatible with the FORTIS Humble stack (build failed: apt "Unable to locate
    package ros-humble-xacro" etc.). The OAK camera needs no Isaac/CUDA, so run the
    Jetson's Humble nodes on a plain Humble/Jammy base via the cpu profile.
    - Dockerfile.dev: multi-arch base selection (amd64 -> osrf/ros:humble-desktop,
    arm64 -> ros:humble-ros-base), mirroring Dockerfile.dev-gpu's TARGETARCH
    base-stage pattern.
    - docker-compose.yml: pass TARGETARCH to the dev build (compose do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
2026-05-31 fix(perception): run OAK v3 Driver component directly (drop bundled RSP)
    The v3 driver.launch.py also starts a robot_state_publisher for the OAK's own
    URDF (depthai_descriptions_v3). That second RSP subscribes to the global
    /joint_states and collides with the FORTIS robot_state_publisher, spamming
    "Robot state publisher ignored an invalid JointState message" at ~10 Hz.
    We don't need the OAK's visual URDF -- the FORTIS URDF already provides
    front_camera_link -- so instantiate the depthai_ros_driver::Driver component
    directly in a ComposableNodeContainer instead of including driver.launch.py.
    The driver still publishes the optical-frame TF from calibration
    (driver.i_publish_tf_from_calibratio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
2026-06-01 fix(docker): install depthai-ros v3 driver runtime deps (diagnostic_updater)
    On the minimal arm64 base (ros:humble-ros-base) the v3 driver plugin failed to
    dlopen libdiagnostic_updater.so. The dep didn't install because the depthai apt
    line used --no-install-recommends and ros-base (unlike osrf desktop) omits it.
    Drop --no-install-recommends for the depthai-ros-v3 install so its recommended
    runtime deps come in, and add ros-humble-diagnostic-updater explicitly. Applied
    to both Dockerfile.dev and Dockerfile.dev-gpu.
2026-06-01 fix(camera): bind full /dev tree + match RGBD fps to fix USB re-enum and sync
    Container: bind the whole host /dev (not just /dev/bus/usb) so the OAK device node survives the USB2-bootloader to USB3-runtime re-enumeration; the narrow bind left a stale handle and the driver failed with Failed to find device after booting.
    Camera config: drop driver.i_device_id (single camera grabs the only OAK on the bus), set rgb/left/right i_fps to a matched 15.0 to fix the RGBD Sync node never-in-sync spam, and turn off stereo subpixel to keep frame rate on the RVC2.
    [oak_chassis_front.yaml]
2026-06-01 fix(camera): run RGBD sync on host to stop OAK-D Lite color/depth desync
    OAK-D Lite color (IMX214) and mono (OV7251) free-run unsynced; frame stamps drift 60-130ms so the on-device Sync node never matches a color+depth pair (spam: messages still not in sync) and /rgbd/points never publishes. depthai-ros exposes no syncThreshold param; rgbd.i_run_sync_on_host:true moves sync to ROS approximate-time, which tolerates the offset. Corrects earlier comments: matched fps and subpixel were not the sync cause.
    [oak_chassis_front.yaml]
2026-06-01 fix(camera): hardware frame-sync OAK-D Lite sensors so RGBD sync succeeds
    Live data showed /rgbd/points never publishes and RGB throttled to ~7Hz: the device color+depth Sync never matches a pair (sensors free-run, stamps drift) and backpressure stalls RGB. i_run_sync_on_host did not help (device builds an intermediate Sync regardless). Tie sensors to one FSIN pulse (rgb continuous source, mono trigger) so capture stamps match at the source. Board-dependent on OAK-D Lite; host-built cloud is the fallback if FSIN is not wired color<->mono.
    [oak_chassis_front.yaml]
2026-06-01 perf(camera): run RGBD align+sync on VPU not host (0.5Hz -> device rate)
    fsync fixed the desync so the on-device Sync now succeeds; host-side align+sync (i_run_*_on_host) emitted the cloud at only ~0.5Hz because the Jetson CPU did the align + point-cloud assembly. Flip sync+align back to the RVC2 VPU.
    [oak_chassis_front.yaml]
2026-06-01 feat(foxglove): multi-view chassis-cam layout; de-clutter 3D TF; add depth panel
    Left half: 3D RGBD cloud + URDF with frame labels hidden and axis triads shrunk (axisScale 0.1) so the cloud is readable instead of a mess of arrows/names. Right: RGB and depth image panels side by side on top, smaller IMU plot + raw-message panel below.
2026-06-01 perf(camera): RGBD at 640x400 per Luxonis example (cloud ~256k pts, not ~2M)
    Root cause of the 0.2-0.5Hz cloud: RGBD aligns depth to color and emits one point per color pixel, so 1080p color = ~2M points/frame the RVC2 cannot assemble fast; backpressure also throttled RGB. Official v3 RGBD example runs color+stereo at 640x400 (~256k pts) at 30Hz -- match it. Keep align+sync on the VPU to offload the Jetson (the prior device-side slowness was the 1080p point count, not the device path). Drop i_fsync_* (Luxonis frame-sync docs: OAK-D Lite does not wire color<->mono FSIN, OV7251 FSYNC not in FW -> no-op; matched fps auto-syncs).
2026-06-01 fix(camera): drop compressedDepth/theora plugins on color topic (kills bgr8 spam)
    image_transport auto-advertises compressedDepth + theora on every image topic; compressedDepth errors every frame on the bgr8 color image. Restrict the color topic enable_pub_plugins to raw + JPEG compressed; depth topic keeps compressedDepth (correct there). Param name/strings confirmed from the live node.
    [oak_chassis_front.yaml]
2026-06-01 fix(camera): static TF bridge front_camera_link -> oak_chassis_front
    Live tf2_echo showed the OAK driver publishes its optical frames rooted at oak_chassis_front (i_tf_base_frame) in a tree DISCONNECTED from the robot: i_tf_parent_frame is a xacro arg consumed by the OAK robot_state_publisher, which this launch skips (to avoid joint_state spam), so the parent attach never happens. Foxglove then cannot transform the image/cloud to base_link. Add a static_transform_publisher front_camera_link -> oak_chassis_front (identity) to join the trees. Also drop the non-existent i_tf_tf_prefix param.
2026-06-01 fix(camera): restrict depth topic transports (drop JPEG compressed on 16UC1)
    The depth topic auto-advertised image_transport/compressed (JPEG), which errors on 16UC1 (not a color format). Restrict stereo/image_raw to raw + compressedDepth.
    [oak_chassis_front.yaml]
2026-06-02 fix(test): deterministic per-package ROS_DOMAIN_ID (de-flake CI)
    The drive/safety/arm/control test suites are sound (pass repeatedly in
    isolation) but flaked in CI. Each ROS-using test conftest isolated its
    process with ROS_DOMAIN_ID=(pid%100)+50, which collides when concurrent
    colcon test processes share a residue mod 100. On a collision the
    integration test mission_state_node latches IDLE (TRANSIENT_LOCAL) onto
    /fortis/mission_state and flips a colliding drive/arm node gate shut,
    producing the clustered state-flip failures.
    Replace the pid-derived ID with fixed unique per-package IDs
    (drive=91, arm=92, control=93, integration=94) in the safe 0-101 range,
    with a shared registry comment. De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
2026-06-04 docs(tools): fix stale CAN chain order, gs_usb status, lock-in comment
    - odrive_calibrate.md: CAN assembly section said FL->FR->RL->RR with RR
    terminated; the calibration table (authoritative) and project convention
    are FL->FR->RR->RL with RL at the terminated far end. Fix the assembly
    order, termination jumper (RL), and next-motor order to match. Dedup the
    garbled lock-in current comment.
    - xdrive_bringup.md: gs_usb is installed on the Jetson now (auto-loads on
    plug-in); rewrite the CAN-up section to name the USB-CAN adapter as the
    committed interface instead of presenting mttcan as a co-equal route.
2026-06-04 docs: fix stale references in protocol, package READMEs, node docstring
    - PROTOCOL.md: firmware file is teensy.ino, not main.ino; protocol version
    is 1.1 (PROTO_MINOR bumped 0->1 for the J4 home bit), not 1.0.
    - fortis_arm/README.md: the arm action server was moved to legacy; only the
    gripper services ship today. Drop present-tense claims about a live
    MoveToPose goal handler; the action type remains reserved in fortis_msgs.
    - fortis_description/README.md: replace the dead E:\ Windows build path with
    the in-container /workspace path.
    - odrive_health_monitor_node.py: replace a fragile line-number reference
    (mission_state_machine.py line 195) with a reference to the wildcard FAULT
    t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
2026-06-04 docs(drive): trim drive_node docstring duplication
    The module docstring Safety stops and Wheel direction sections repeated the
    per-constant comments on CMD_VEL_TIMEOUT_S, WHEEL_DIRECTION, and
    CMD_VEL_FRAME_SIGN almost verbatim. Condense them to brief pointers; the
    authoritative why now lives only on the constants. No substance dropped.
2026-06-04 feat(camera): multi-cam bring-up - independent RGB MJPEG + depth, no cloud
    - oak_chassis_front.yaml: i_enable_rgbd off; RGB on-device MJPEG via
    i_low_bandwidth + i_publish_compressed; drop dead rgbd block; depth
    unchanged (regular 16UC1, compressedDepth transport). Capture/timing frozen.
    - oak_chassis_front.launch.py: drop the i_enable_rgbd:True override.
    - oak_chassis_cameras.launch.py: NEW - discover all OAKs, start one Driver
    each (oak_cam_N, serial-pinned), reuse front config as a node-scoped dict.
    - foxglove/fortis_chassis_cams.json: NEW - 4-tab toggle, one camera per tab.
2026-06-05 feat(camera): pin OAK serials to chassis positions, depth via compressedDepth
    - oak_chassis_cameras.launch.py: CAMERA_ROSTER maps each serial to its position
    (front/rear/left/right), so node names + topics are stable regardless of USB
    enumeration order. Discovery still only spawns connected cameras.
    - foxglove/fortis_chassis_cams.json: tabs renamed Front/Rear/Left/Right on the
    oak_chassis_* topics; depth panels use the compressedDepth transport to cut
    streaming bandwidth (raw 16UC1 depth was the lag driver).
    Serial map (confirmed live 2026-06-05):
    front 19443010610BDE7D00 | rear 19443010C1DF397E00
    left 1944301011323C7E00 | right 1944301031353C7E00
2026-06-05 fix(foxglove): depth panels back to raw, drop stale single-cam layout
    - compressedDepth/compressed depth do not render in Foxglove -> point the
    depth panels back at /oak_chassis_*/stereo/image_raw (raw 16UC1). Raw depth
    is bandwidth-heavy over wifi; the wired CAT5 link is the lag fix for it.
    - remove foxglove/fortis_chassis_cam.json (stale single-cam layout, referenced
    the removed RGBD cloud topic) -- fortis_chassis_cams.json supersedes it.
2026-06-05 fix(camera): satisfy pydocstyle on the multi-cam launch docstrings
    Module + _discover_device_ids docstrings: one-line summary ending in a period,
    blank line before the body, imperative mood, closing quotes on their own line
    (D205/D209/D400/D401). No behavior change.
2026-06-05 ci: run colcon test with --executor sequential (cross-talk safety net)
    Belt-and-suspenders for the per-package ROS_DOMAIN_ID fix: serialize
    test execution so ROS test processes never overlap on a shared DDS
    domain even if a new package omits its conftest isolation.
2026-06-05 feat(drive): ODrive gain re-apply script + can0 velocity-tuning runbook
    Version-controlled apply-script (velocity mode, vel-loop P/I, velocity/current
    limits; inertia 0, current BW untouched) restores tuned drive after a re-flash.
    Runbook fixed to can0 and scoped to the velocity loop. Gain values filled after
    the live Jetson session.
2026-06-05 chore(vendor): prune unused odrive_botwheel_explorer via vendor_import wrapper
2026-06-05 docs(integration): correct safety-arm test row to match active test
    The README described test_safety_arm_integration.py as @pytest.mark.skip
    placeholders, but commit 4d4b3ae replaced that scaffold with a real,
    active gripper-service gating integration test (test_00..test_09, real
    assertions). Update the Tests table row to describe what the file
    actually exercises so the README is accurate.
    No test files, conftest, or production code touched. The file was NOT
    deleted: it is a live cross-package safety+arm contract test, not dead
    weight.
2026-06-05 chore(vendor): also prune unused odrive_node from vendoring
    odrive_node is a standalone upstream CAN node we don't use; prune it
    alongside odrive_botwheel_explorer so neither adds local colcon build time.
    odrive_ros2_control + odrive_base remain.
2026-06-06 test(teensy): add stepper bring-up sketches (J1 nudge + 3-joint arm)
    Standalone bench sketches that drive the steppers directly via TeensyStep4,
    bypassing the FORTIS protocol/homing so the hardware chain can be validated
    before the real firmware path exists.
    - stepper_j1_nudge: single-joint keypress jog/run with safe gating + ALM watch
    - stepper_arm: all 3 steppers + J4 wrist servo + gripper, individual or
    coordinated (group) moves, live speed control (< / >), spacebar kill
    Validated end-to-end on hardware (Teensy -> TXS0108E -> CL57T-V41 -> NEMA-23
    w/ 50:1 gearbox). Bench note: J1/J3 STEP/DIR intentionally swapped vs the
    teensy.ino pin map for the current harness (documented in the sket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
    [stepper_arm.ino, stepper_j1_nudge.ino]
2026-06-06 test(teensy): add gripper_hold sketch + repurpose servo_sweep for gripper
    servo_sweep moved from J4 (pin 28) to the gripper slot (pin 29) with a
    conservative 1200-2300us window; gripper_hold cycles release/grip on a timer
    to check the gripper holds a commanded position without current creep.
2026-06-06 docs(teensy): HANDOFF cleanup — renames, resolved blockers, TODO status
    - main.ino -> teensy.ino references throughout
    - urdf/ -> src/fortis_description/ note
    - S8.1 (TeensyStep compile) and S8.2 (mock watchdog) marked RESOLVED with history
    - S9 TODO table: readMcuTempC10 and J4 home marked done; stepper homing still open
    - S10 step 1 marked done
2026-06-07 fix(drive): persist tuned ODrive vel gains + 40A current-hard-max margin
    All four wheels vel_gain=0.925 vel_integrator_gain=1.0, tuned live and verified on hardware. current_hard_max 30 to 40A restores headroom above current_soft_max 30; zero margin trips CURRENT_LIMIT_VIOLATION on transients. validate_table now rejects zero-margin. odrivetool docstring refs can0 to can1.
2026-06-07 fix(drive): default launch can_interface to can1 (gs_usb ODrive bus)
    can0 is the onboard Tegra mttcan, not wired to the ODrives; the gs_usb USB-CAN adapter is can1. Both drive launch files default to can1 so operators drop the manual override. Tests pass can_interface explicitly, so CI is unaffected.
2026-06-08 feat(docker): bring can1 up via container entrypoint
    docker/can-up.sh runs at container start (privileged + host-net) to bring the ODrive bus up at 250k, tolerant if the adapter is absent. Drops the manual ip link step before ./stack up.
2026-06-08 feat(drive): velocity-loop autotuner via step-response search
    tools/odrive_autotune.py: coarse-to-fine grid search scoring rise/overshoot/settling/ss-error/oscillation, picks the lowest-cost stable gains. codify() writes winners into apply_gains.py. Runs in odrivetool over can1, on-ground loaded.
2026-06-08 fix(kinematics): wheelbase/track from measured contact spans
    LEN_X 0.176->0.174625 (13.75 in front-back /2), LEN_Y 0.125->0.12065 (9.5 in left-right /2). URDF wheel_x/y_offset updated to match (keeps test_kinematics_urdf_sync passing). Measured 2026-06-07.
    [fortis_constants.xacro]
2026-06-08 feat(localization): wheel odometry + robot_localization EKF (X-drive)
    Add the fortis_localization ament_python package: the estimation layer
    above the existing velocity drive.
    wheel_odometry_node:
    /joint_states -> per-name wheel velocities (rad/s) -> m/s via
    WHEEL_RADIUS -> xdrive_fk_solver (reused from fortis_comms) -> body
    twist -> header-stamp integration -> /odom (nav_msgs/Odometry,
    odom->base_link). Does NOT broadcast TF; the EKF owns odom->base_link.
    Twist covariance is deliberately loose (stale CAN-loop wheel velocity)
    so the EKF leans on the IMU gyro for fast yaw.
    config/ekf.yaml:
    robot_localization ekf, two_d_mode, world_frame=odom, publish_tf.
    Fuses /odom (vx, vy,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
2026-06-08 feat(tools): X-drive kinematic calibration calculator
    Add tools/kinematic_calibration.py: a standalone, off-robot calculator
    that turns UMBmark-style drive measurements into corrected X-drive
    kinematic constants (WHEEL_RADIUS and the LEN_X+LEN_Y rotation lever arm).
    Three independently runnable sub-calibrations:
    1. effective wheel radius from a dead-straight roll: r_eff = D/(2*pi*N)
    2. pure-forward UMBmark: forward scale + lateral/heading cross-coupling
    3. pure-rotation UMBmark: (LEN_X+LEN_Y)_eff = nominal * cmd/act yaw
    Pure Python (stdlib only), argparse CLI, no ROS deps. Prints corrected
    values next to nominals and notes the constants must be applied to BOTH
    fortis_constants.xacro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
2026-06-08 fix(localization): make the EKF IMU-dominant for yaw
    The RR/RL wheels slip under load, so wheel yaw rate is actively
    misleading, not merely noisy. Stop fusing wheel-odometry vyaw entirely
    (odom0_config yaw-rate entry -> false) and keep the IMU gyro yaw rate as
    the sole yaw input. Wheel vx/vy stay fused but loose (the only
    translation source, but they slip). two_d_mode stays true; yaw/vyaw
    process noise stays high so the filter tracks the gyro fast. Comments
    state the IMU-owns-yaw trust rationale and how the IMU/wheel covariance
    ratio (not a per-sensor override, which ekf_node lacks) sets the trust.
2026-06-08 feat(drive): heading-hold PID node closing the loop on EKF yaw
    Add heading_hold_node: subscribes operator /cmd_vel + the EKF
    /odometry/filtered, holds heading with a full PID on the wrapped yaw
    error, and republishes the corrected Twist on /cmd_vel_heading. Vx/Vy
    pass through untouched; while the operator actively turns (|omega_cmd| >
    turn_deadband) omega passes through and the hold target re-arms to the
    current yaw, so releasing the turn holds the new heading. Integral
    anti-windup (clamps the I term), output clamp to max_omega, derivative on
    the wrapped error, stamp-driven dt. Gains (kp/ki/kd/max_omega/
    turn_deadband/i_clamp) and the gyro-direction yaw_sign are
    declare_parameter knobs defau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
    [bringup_params.yaml, test_heading_hold_node.py]
2026-06-08 fix(localization): real OAK IMU topic + one-command heading-hold test
    depthai v3 publishes the IMU at /oak_chassis_front/imu/data, not /oak_chassis_front/imu -> fixed the EKF imu_topic default. drive_test now forwards localization + heading_hold to bringup, so one command brings up the full heading-hold stack.
2026-06-08 feat(localization): auto gyro-bias estimator/remover upstream of the EKF
    The EKF fuses the OAK-D Lite BMI270 gyro yaw rate as the SOLE yaw source
    (wheel vyaw is off because the wheels slip). The gyro's small zero-rate
    bias integrates into a heading drift that creeps the robot under
    heading-hold. Subtract the gyro-Z bias before the EKF sees it.
    New imu_gyro_debias_node (fortis_localization):
    - Estimates a slow EMA of angular_velocity.z while the drive is DISARMED
    (/fortis/drive/armed == false) -- the robot is physically still then, so
    the gyro reads pure bias. Keying on disarmed (not a measured velocity)
    avoids the chicken-and-egg where bias-driven creep keeps the wheels
    moving so a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
    [bringup_params.yaml]
2026-06-11 feat(drive): hold-to-run face-center orbit + one-command orbit launch
    orbit_node turns a held Foxglove ORBIT button (/fortis/commands/orbit_dir) into a continuous face-the-center orbit on /cmd_vel: pure orbit_twist() gives Vy=+/-v and omega=+/-v/R (open-loop, no localization), with a hold dead-man that stops on release. drive_node gates and sign-corrects it like any teleop command. Adds 6 orbit_twist unit tests, an orbit arg (default off) in bringup/drive_test, the chassis_orbit one-command launch (4 cameras + drive stack + orbit + bridge), the orbit_node params block, and ORBIT CCW/CW hold buttons in the Foxglove teleop layout.
    [bringup_params.yaml, test_orbit_node.py]
2026-06-11 refactor(bringup): make multi-camera bring-up primary; share OAK config
    Rename oak_chassis_front.yaml -> oak_chassis_cameras.yaml and make it node-agnostic (positional /** key; image_transport block no longer keyed by a node name). Extract one load_camera_params() loader and route both the 4-camera launch (primary) and the single-cam front debug launch through it, so the front launch no longer passes the file directly. Loader output is byte-identical to the previous dict -- camera streams unchanged. Front debug launch kept (localization relies on its front_camera_link TF chain). Docs refreshed: multi-cam documented as primary; accurate v3/MJPEG/no-cloud details.
    [oak_chassis_cameras.yaml]
2026-06-11 fix(drive): orbit faces center - omega_sign -1 (bench-verified)
    On hardware the face-center orbit locked the BACK toward the center (facing outward) with omega_sign=+1. The Vy/omega coupling sign in orbit_twist is mount/convention-dependent (the H-matrix Vy/omega signs were never re-derived); omega_sign is the boundary knob for exactly this. -1.0 makes the front cameras face the center. Both ORBIT buttons now face-center; left/right select the two rotation directions.
    [bringup_params.yaml]
2026-07-08 fix(localization): first armed msg is init, not a disarm edge
    The debias node assumed armed=True at startup, so a robot that launches disarmed registered a phantom arm->disarm edge and sat in the settle window; model armed as unknown-until-first-msg instead. Fixes test_ema_converges_to_constant_offset_while_disarmed.
2026-07-08 feat(msgs): ArmStatus, MapDiffSummary, SaveMap/LoadMap interfaces
    Interfaces for the perception + arm-bridge sprint: decoded Teensy RSP_STATUS with connectivity flag, voxel-map cross-run diff roll-up, and map persistence services.
2026-07-08 build(docker): perception deps in dev + dev-gpu images
    vision_msgs, foxglove_msgs, image_geometry, sensor_msgs_py, cv_bridge, python3-opencv for the fortis_perception / fortis_sim_support packages. All are valid Humble rosdep keys, so CI resolves them from package.xml.
2026-07-08 feat(bringup,foxglove): attach 4-cam TF roots to URDF; perception + arm layouts
    oak_chassis_cameras.launch.py now bridges <pos>_camera_link -> oak_chassis_<pos> per roster camera (same identity bridge the front debug launch used). New Foxglove layouts: fortis_perception.json (3D fused cloud/map/diff/detections + click-to-target on /clicked_point), fortis_arm.json (service buttons, joint plot, ArmStatus); teleop layout gains FSM event buttons + diagnostics.
2026-07-08 feat(sim): synthetic scene, raycaster, trajectories, OAK replayer + tests
    Procedural RGBD scene (speckle-textured primitives, baseline/modified variants), vectorized numpy raycaster, exact analytic trajectories, and a replayer node publishing the full depthai v3 OAK topic contract (jpeg rgb, 16UC1 aligned depth, camera_info pair, IMU) plus /fortis/sim/ground_truth and optional TF. 20 tests: exact-geometry raycaster, orbit kinematics, live topic-contract smoke.
2026-07-08 feat(arm): Teensy serial bridge, protocol lib, calibration; gripper services live
    teensy_protocol.py implements PROTOCOL.md framing (CRC-16-CCITT over SEQ..PAYLOAD per firmware, vectors asserted). teensy_bridge_node: reconnect-forever serial, 20Hz heartbeat, RSP_STATUS -> ArmStatus + /joint_states + /diagnostics, EVT_FAULT -> /fortis/events/fault, JointState commands -> SET_JOINT_TARGETS, enable/disable/home/clear_faults services. arm_controller gripper services now publish real commands. 34 tests incl. live runs against tools/mock_teensy.py with fault injection.
    [arm_calibration.yaml]
2026-07-08 feat(perception): detectors, detection node, click-to-target, system health
    HSV blob detector (CI path) + YOLOv8n via cv2.dnn with graceful ModelUnavailable degradation and a pinned-URL download script. detection_node publishes 2D/3D detections, base_link markers, Foxglove annotations, GraspCandidate + grasp_candidate_ok. target_selector wires /clicked_point -> target_pose + target_pose_valid/ik_ok + /fortis/events/chassis_cam_click (ORBIT->TARGETING). system_health publishes /diagnostics rates.
2026-07-08 feat(perception): depth->cloud, multi-cam fusion, voxel map save/load, cross-run diff
    depth_to_cloud reprojects jpeg rgb + 16UC1 depth into XYZRGB clouds (cached index grids, stride decimation). cloud_fusion tf2-transforms per-camera clouds into base_link and voxel-downsamples. voxel_grid is the pure hit-counted map with npz save/load and set-op diff; voxel_map_node integrates in odom and serves SaveMap/LoadMap/clear; map_diff_node publishes added/removed CUBE_LIST markers + latched MapDiffSummary. 11 new tests incl. full map->save->diff pipeline.
2026-07-08 fix(sim): footprint-faded two-octave speckle - stop texture aliasing
    Point-sampled 7mm speckle aliased beyond ~1.5m, so the same surface rendered differently per viewpoint and silently corrupted feature matching (VO lost tracking ~25% of orbit frames). Each octave now fades as pixel footprint exceeds its cell (poor mans mip-map) and an 8x-coarser octave keeps distant surfaces trackable. Orbit VO went from 21% ATE with dropouts to 0.6% with zero losses.
2026-07-08 feat(perception,localization): RGBD visual odometry + opt-in EKF fusion
    rgbd_vo.py: keyframe-anchored ORB + depth-lifted solvePnPRansac with LM refinement on inliers and a physical plausibility gate (a degenerate RANSAC solve can pass the inlier count with a wild pose; one such frame would poison the integrated pose forever). rgbd_vo_node publishes /fortis/vo mapped to base_link with inlier-scaled covariance. ekf_vio.yaml fuses VO vx/vy (yaw stays IMU-owned); localization.launch.py gains vio:=true. Orbit acceptance test: final ATE 0.6% of path (bar: 5%).
2026-07-08 feat(bringup): perception.launch.py demo entry; perception/arm opt-ins; chain acceptance test
    perception.launch.py composes the full synthetic-or-real perception stack (replayer or 4 cams -> clouds -> fusion -> voxel map -> VO -> detection -> targeting -> health, one foxglove bridge). bringup.launch.py gains perception:=false / arm:=false opt-ins (GroupAction-scoped so include args do not leak). test_perception_chain.py drives the whole chain to TARGETING and a saved map - verified live: fused cloud 2.4k pts, map 27k voxels, VO on base_link, zero launch errors.
2026-07-08 fix(perception): verified real YOLOv8 path - pin weights, cv2>=4.7 gate, pad-box drop
    The original weights URL 404d and apt OpenCV 4.5.4 cannot run YOLOv8 heads at all - both found by actually exercising the path. Weights now pinned to a HuggingFace revision hash + enforced SHA256; detector raises ModelUnavailable on cv2 < 4.7 so nodes degrade instead of crashing; boxes that unmap entirely into the letterbox padding are dropped (real inference produced (0,0,0,-59)). Dockerfiles add pip opencv-python-headless (apt cv2 stays for cv_bridge). Real-weights test now runs in-container: 26/26, no skips.
2026-07-08 feat(sim,bringup): 4-camera synthetic rig; refresh root README status
    oak_replayer_node gains mount presets for all four chassis cameras (poses cited from the URDF; publish_base_tf gates the single odom->base_link owner). synthetic_oak.launch.py and perception.launch.py synthetic mode spawn one replayer per camera. New tests: multicam TF/topic rig + 4-view fusion integration (fused cloud exceeds any single view). README status table now reflects the implemented perception/sim/arm stack.
2026-07-08 feat(arm): analytic 4-DOF IK, MoveToPose action server, full-mission acceptance test
    arm_ik.py: pure FK/IK (link lengths cited from the URDF), elbow up/down, limit filtering, <1mm FK->IK->FK round-trip over an 81-config grid. arm_motion_node: real /fortis/context/ik_ok from /fortis/target_pose (replaces the target_selector placeholder), move_to_pose action streaming interpolated JointState waypoints through the teensy bridge, fires arm_at_view_pose on success. test_full_mission.py drives the ENTIRE mission FSM against the synthetic camera + mock Teensy: IDLE->ORBIT->TARGETING->ARM_AT_VIEW->PICK (gripper_us verified 1500->1100)->HOLDING->RETURN_HOME->IDLE.
    [arm_ik.py, arm_motion_node.py]
2026-07-08 refactor+docs(perception,sim,bringup): consolidate shared helpers; handoff docs
    New fortis_perception geometry.py (URDF front-cam extrinsic, shared by VO + detection) and cloud_utils.py (XYZRGB fields/packing + transform helper) replace node-to-node helper imports. Dead pre-pin branches dropped from download_models. READMEs gain per-node param/topic sections, pipeline data-flow, mount-preset + anti-aliased-speckle rationale; registry row for ik_ok corrected to arm_motion. Behavior-preserving: full suite 226/226.
    [bringup_params.yaml]
2026-08-02 feat(bringup): launch arm_motion with the arm seam
2026-08-02 fix(bringup): params file matches real declared parameters
    [bringup_params.yaml]
2026-08-02 feat(safety): odrive_status -> OdriveHealth bridge
2026-08-02 chore: prune legacy, deprecated isaac scripts, stale sim dumps and their dangling refs
    [30in_loaded_step_v4_mc20.csv]
2026-10-20 Send arm goals once and let the firmware run the move
2026-10-20 Add optional second IMU to the EKF
2026-10-20 Publish wheel slip residual from FK
